BehrensG/ETH1CVOLT/README.md

# ETH1CVOLT
One channel +/- 100V, +/-10V range voltage source
