BehrensG/ETH1CVOLT/HARDWARE/SIM/LTSPICE/ADR1399_Voltage_Reference.asc

C1: cap; 10µ; V=35 Irms=0 Rser=0 Lser=0 mfg="Murata" pn="GRM21BR6YA106ME43" type="X5R"
R1: res; 2k67
R2: res; 100
R3: res; 8k2
R4: res; 8k2
R5: res; 20k
R6: res; 20k
R7: res; 10k
R8: res; 10k
U1: ADR1399H
U2: OPAx192
U3: OPAx192
U4: OPAx192
V1: voltage; 14
V2: voltage; -14
Named nets: 0, VCC, VEE, REF5V, REF10V
.tran 1
