BehrensG/ETH1CVOLT/HARDWARE/SIM/LTSPICE/Draft3.asc

C1: cap; 10µ; V=35 Irms=0 Rser=0 Lser=0 mfg="Murata" pn="GRM21BR6YA106ME43" type="X5R"
R1: res; 2k67
R2: res; 100
U1: ADR1399H
V1: voltage; 14
V2: voltage; -14
Named nets: 0, VCC, VEE
