BehrensG/ETH1CVOLT/HARDWARE/SIM/LTSPICE/Voltage_Source.asc

R1: res; 10k
R2: res; 10k
R3: res; 10k
R4: res; 30k
R5: res; 10k
R6: res; 10k
U1: OPAx192
U2: OPAx192
U3: ADA4522-2
U4: ADA4522-2
U6: MAX44241
V1: voltage; -14
V2: voltage; 14
V3: voltage; -22
V4: voltage; 22
V5: voltage; SINE(0 5 50)
Named nets: 0, VDD, VSS, VGG, VEE, MEAS_R20V, MEAS_R10V, R20V, R10V
.tran 0.1
