BehrensG/ETH1CVOLT/HARDWARE/SIM/LTSPICE/Isolated_Current_Measurement.asc

C1: cap; 0.001µ; V=2K Irms=0 Rser=0.3435 Lser=392p mfg="Würth Elektronik" pn="885342209009 WCAP-CSMH 1210" type="X7R"
R1: res; 10
R2: res; 10k
R3: res; 10k
R4: res; 1Meg
R5: res; 499
R6: res; 1Meg
R7: res; 1Meg
U1: AD8224
V1: voltage; 50
V2: voltage; -15
V3: voltage; 15
Named nets: 0
.tran 0.2
