BehrensG/ETH1CVOLT/HARDWARE/SIM/LTSPICE/Diff_To_Single.asc

R1: res; 49.9k
R2: res; 49.9k
R3: res; 10k
U1: ADA4522
U2: AD8475
V1: voltage; 21
V2: voltage; -21
V3: voltage; SINE(0 25 100 0 0 0 100)
V4: voltage; 5
V5: voltage; 2.5
Named nets: 0, VSS, VCC, VDD, VREF
.tran 0.05
