BehrensG/ETH1CVOLT/HARDWARE/SIM/LTSPICE/Draft1.asc

U1: AD8475
V1: voltage; 5
V2: voltage; SINE(0 10 100 0 0 0 10)
V3: voltage; 5
Named nets: 0, VDD, VREF
