BehrensG/ETH1CVOLT/HARDWARE/SIM/LTSPICE/ADHV4702-1.asc

C1: cap; 82p
Q1: npn; 2N5550
Q2: pnp; 2N5401
R1: res; 40k
R2: res; 10k
R3: res; 120
R4: res; 1k
R5: res; 500
R6: res; 5
R7: res; 500
R8: res; 10k
R9: res; 5
R10: res; 100k
U1: ADHV4702-1
U2: ADHV4702-1
V1: voltage; 110
V2: voltage; -110
V3: voltage; SINE(0 20 1000); AC 10
Named nets: 0, +VCC2, -VCC2
.tran 30m
