BehrensG/ETH1CVOLT/HARDWARE/SIM/LTSPICE/SumAmp.asc

R1: res; 10k
R2: res; 10k
R3: res; 100k
R4: res; 10k
R5: res; 10k
U1: LT1022
U2: LT1022
U3: LT1022
U4: LT1022
V1: voltage; 15
V2: voltage; -15
V3: voltage; -10
V5: voltage; 10
Named nets: 0, P15V, N15V
.tran 0.1
