BehrensG/ETH1CVOLT/HARDWARE/SIM/LTSPICE/Discharge.asc

C1: cap; 4.7µ
C2: cap; 10µ
R1: res; 4k7
S1: sw; MYSW
S2: sw; MYSW
V1: voltage; 110V
V2: voltage; PULSE(5 0 0.5 10n 10n 2 2)
V3: voltage; PULSE(0 5 0.5 10n 10n 2 2)
Named nets: 0
.model MYSW SW()
.tran 2
