BehrensG/ETH1CVOLT/HARDWARE/SIM/LTSPICE/CapacMulti.asc

C1: cap; 100µ
Q1: npn; FZT849
R1: res; 499
R2: res; 499k
R3: res; 10
V1: voltage; 9
Named nets: 0
.tran 0.1
