BehrensG/ETH1CVOLT/HARDWARE/SIM/LTSPICE/LT8330_LV.asc

C1: cap; 1µ
C2: cap; 1µ; V=50 Irms=0 Rser=0 Lser=0 mfg="Murata" pn="GCM21BR71H105MA03" type="X7R"
C3: cap; 4.7p; V=50 Irms=0 Rser=0.4971 Lser=498p mfg="Würth Elektronik" pn="885012007049 WCAP-CSGP 0805" type="NP0"
C4: cap; 4.7µ; V=50 Irms=0 Rser=0 Lser=0 mfg="Murata" pn="GRM31CR71H475KA12" type="X7R"
C5: cap; 10µ; V=50 Irms=0 Rser=0.003 Lser=1.2n mfg="Würth Elektronik" pn="885012214005 WCAP-CSGP 2220" type="X7R"
C11: cap; 1µ
C12: cap; 1µ; V=50 Irms=0 Rser=0 Lser=0 mfg="Murata" pn="GCM21BR71H105MA03" type="X7R"
C13: cap; 4.7p; V=50 Irms=0 Rser=0.4971 Lser=498p mfg="Würth Elektronik" pn="885012007049 WCAP-CSGP 0805" type="NP0"
C14: cap; 4.7µ; V=50 Irms=0 Rser=0 Lser=0 mfg="Murata" pn="GRM31CR71H475KA12" type="X7R"
C15: cap; 10µ; V=50 Irms=0 Rser=0.003 Lser=1.2n mfg="Würth Elektronik" pn="885012214005 WCAP-CSGP 2220" type="X7R"
D1: diode; PMEG6010AED
D3: diode; PMEG6010AED
L1: WE-TDC_HV
L2: WE-TDC_HV
R1: res; 499k
R2: res; 39k
R3: res; 400
R7: res; 499k
R8: res; 18k7
R9: res; 400
U1: LT8330
U3: LT8330
V1: voltage; 24
V3: voltage; 24
Named nets: 0
.tran 0.01
