BehrensG/ETH1CVOLT/HARDWARE/SIM/LTSPICE/LT8330_MV.asc

C11: cap; 1µ
C12: cap; 1µ; V=50 Irms=0 Rser=0 Lser=0 mfg="Murata" pn="GCM21BR71H105MA03" type="X7R"
C13: cap; 4.7p; V=50 Irms=0 Rser=0.4971 Lser=498p mfg="Würth Elektronik" pn="885012007049 WCAP-CSGP 0805" type="NP0"
C14: cap; 4.7µ; V=50 Irms=0 Rser=0 Lser=0 mfg="Murata" pn="GRM31CR71H475KA12" type="X7R"
C15: cap; 10µ; V=50 Irms=0 Rser=0.003 Lser=1.2n mfg="Würth Elektronik" pn="885012214005 WCAP-CSGP 2220" type="X7R"
C16: cap; 1µ
C18: cap; 4.7p; V=50 Irms=0 Rser=0.4971 Lser=498p mfg="Würth Elektronik" pn="885012007049 WCAP-CSGP 0805" type="NP0"
C19: cap; 4.7µ; V=50 Irms=0 Rser=0 Lser=0 mfg="Murata" pn="GRM31CR71H475KA12" type="X7R"
C20: cap; 10µ; V=50 Irms=0 Rser=0.003 Lser=1.2n mfg="Würth Elektronik" pn="885012214005 WCAP-CSGP 2220" type="X7R"
D3: diode; PMEG6010AED
D4: diode; PMEG6010AED
L1: ind; 6.8µ; Ipk=1 Rser=0.25 Rpar=4000 Cpar=1.9p mfg="Würth Elektronik" pn="74479887268A WE-PMI 1008"
L2: WE-TDC_HV
R7: res; 499k
R8: res; 10k
R9: res; 400
R10: res; 499k
R11: res; 18k8
R12: res; 600
U3: LT8330
U4: LT8330
V3: voltage; 24
V4: voltage; 24
Named nets: 0
.tran 0.01
