BehrensG/ETH1CVOLT/HARDWARE/SIM/LTSPICE/LT8365_N.asc

C1: cap; 0.01µ; V=100 Irms=0 Rser=0.0821 Lser=506p mfg="Würth Elektronik" pn="885012208112 WCAP-CSGP 1206" type="X7R"
C2: cap; 0.1µ; V=100 Irms=0 Rser=0 Lser=0 mfg="Murata" pn="GCM21BR72A104KA37" type="X7R"
C3: cap; 0.1µ; V=100 Irms=0 Rser=0 Lser=0 mfg="Murata" pn="GCM21BR72A104KA37" type="X7R"
C4: cap; 1µ
C5: cap; 0.0018µ; V=100 Irms=0 Rser=0 Lser=0 mfg="Murata" pn="GCM155R72A182JA37" type="X7R"
C6: cap; 0.22µ; V=100 Irms=1.43 Rser=0.066313 Lser=0 mfg="KEMET" pn="C1812F224K1RAC" type="X7R"
C7: cap; 0.22µ; V=100 Irms=1.43 Rser=0.066313 Lser=0 mfg="KEMET" pn="C1812F224K1RAC" type="X7R"
C8: cap; 10µ; V=200 Irms=310m Rser=0.7365 Lser=4.499n mfg="Würth Elektronik" pn="860241075003 WCAP-AT1H 10x20" type="Al electrolytic"
C9: cap; 4.7µ; V=250 Irms=60m Rser=1.1257 Lser=4.219n mfg="Würth Elektronik" pn="860131175004 WCAP-ATET 10x12,5" type="Al electrolytic"
C10: cap; 10µ; V=50 Irms=0 Rser=0.008 Lser=402p mfg="Würth Elektronik" pn="885012209073 WCAP-CSGP 1210" type="X7R"
C11: cap; 4.7µ; V=50 Irms=0 Rser=0 Lser=0 mfg="Murata" pn="GRM21BZ71H475KE15" type="X7R"
D1: diode; MBRS1100
D2: diode; MBRS1100
D3: diode; MBRS1100
D4: diode; MBRS1100
L1: ind2; 10µ; Ipk=0.94 Rser=0.19 Rpar=6292.1 Cpar=715f mfg="Würth Elektronik" pn="74406032100 WE-LQFS 3818"
R1: res; 107K
R2: res; 44.2k
R3: res; 20
R4: res; 20
R5: res; 47
R6: res; 499k
R7: res; 499k
R8: res; 7k32
R9: res; 7k4
U1: LT8365
V1: VOLTAGE; 24
Named nets: 0, IN
.tran 0.1 startup
