BehrensG/ETH1CVOLT/HARDWARE/ETH1CVOLT/ETH1CVOLT.kicad_pcb

## KiCad design HARDWARE/ETH1CVOLT/ETH1CVOLT.kicad_pcb (2026-10-23)

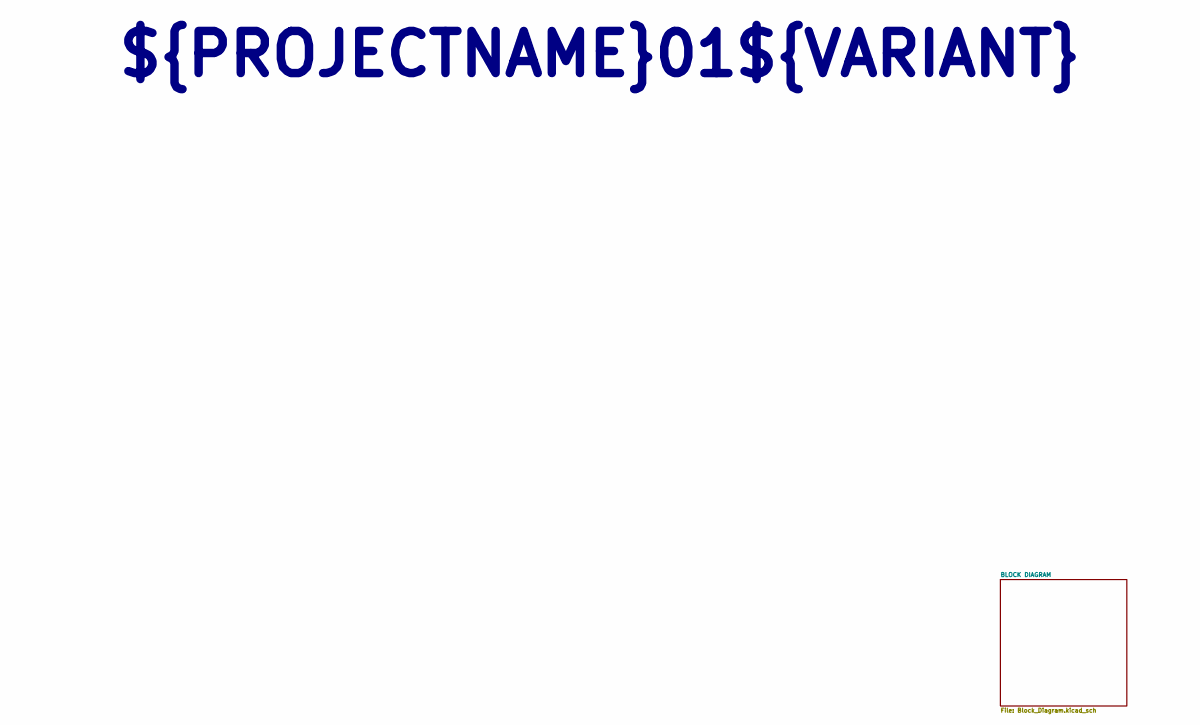
[picture p1: schematic ETH1CVOLT.kicad_sch]

Notes on the sheet:
${PROJECTNAME}${REVISION}${VARIANT}

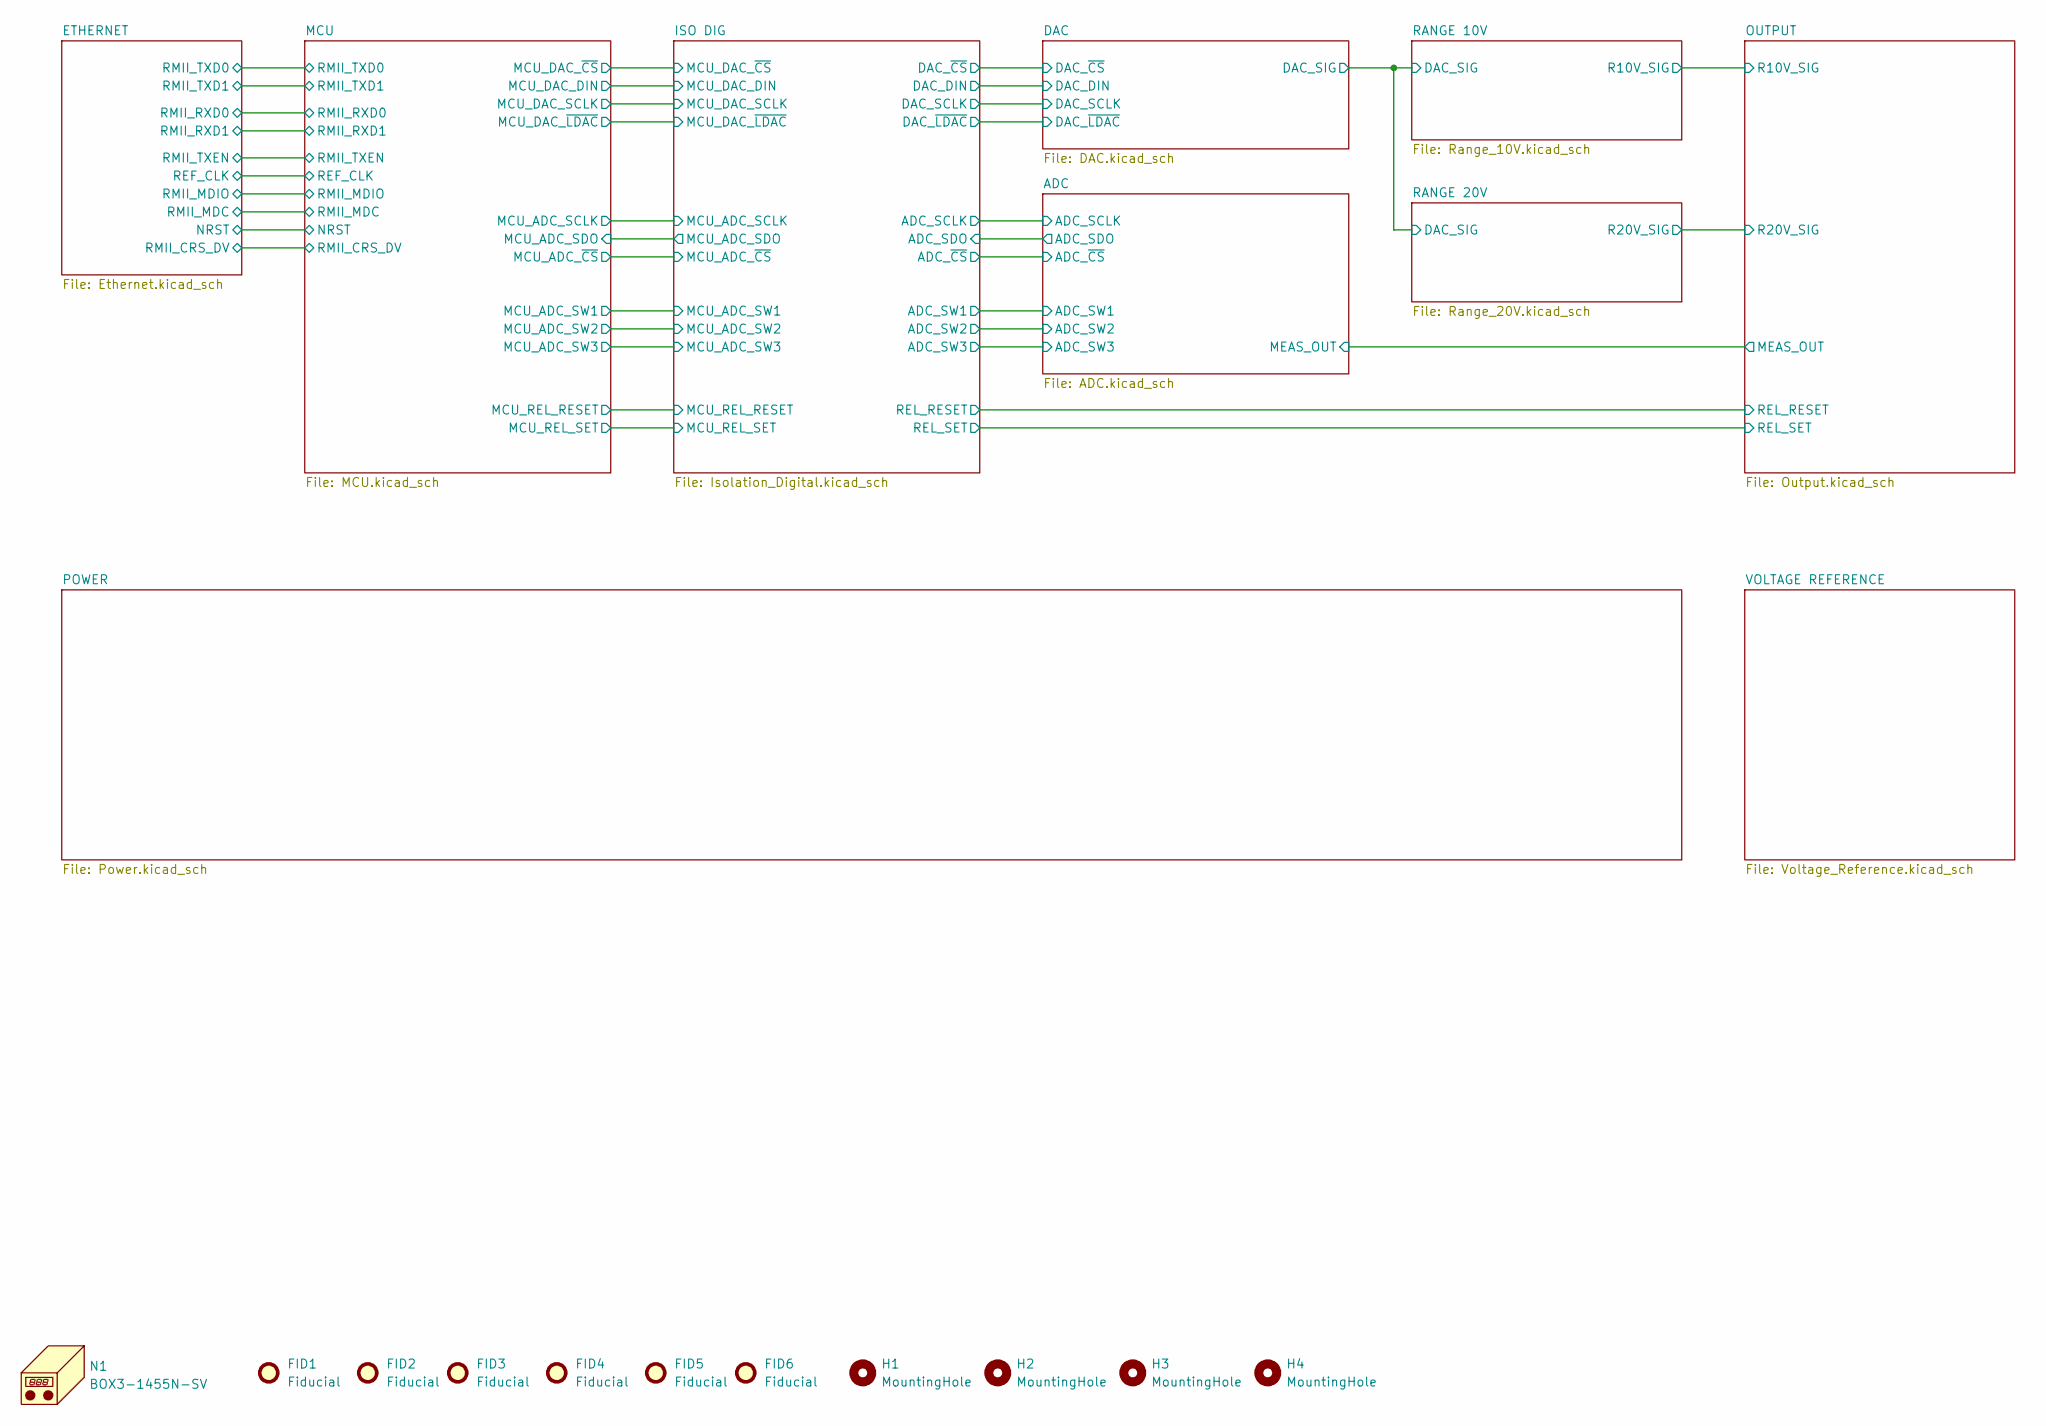
[picture p2: schematic Block_Diagram.kicad_sch, ETH1CVOLT]

Parts:
FID1, FID2, FID3, FID4, FID5, FID6: Fiducial; Fiducial_1.5mm_Mask3mm
H1, H2, H3, H4: MountingHole; MountingHole_3.2mm_M3
N1: BOX3-1455N-SV; BOX3-1455N

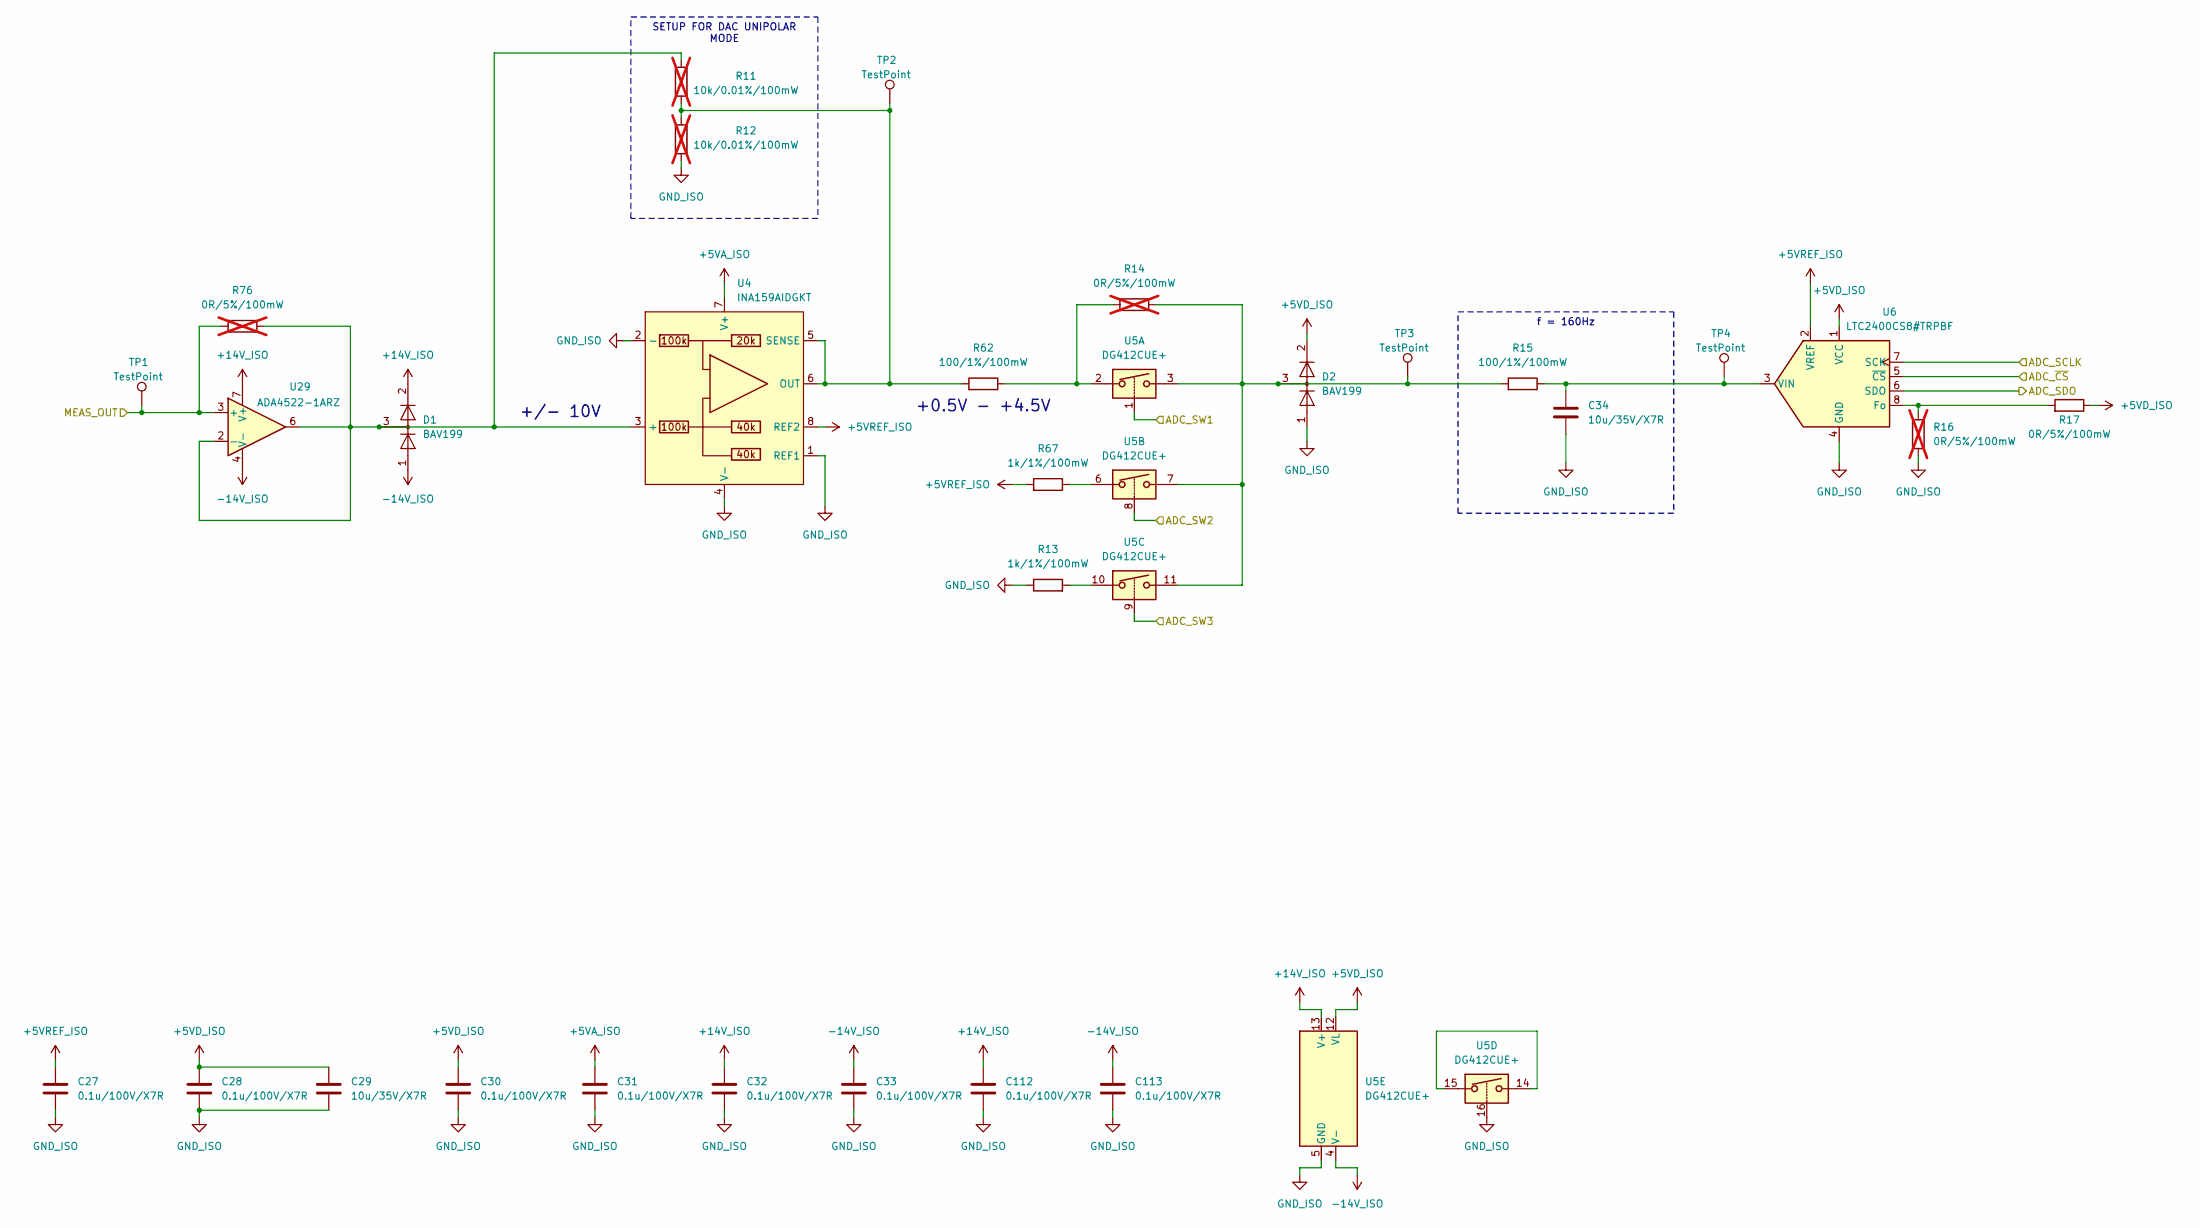
[picture p3: schematic ADC.kicad_sch, ETH1CVOLT]

Parts:
C27, C28, C30, C31, C32, C33, C112, C113: 0.1u/100V/X7R; C_0603_1608Metric_Pad1.08x0.95mm_HandSolder
C29, C34: 10u/35V/X7R; C_1206_3216Metric_Pad1.33x1.80mm_HandSolder
D1, D2: BAV199; SOT-23
R11, R12: 10k/0.01%/100mW; R_0603_1608Metric_Pad0.98x0.95mm_HandSolder; not fitted
R13, R67: 1k/1%/100mW; R_0603_1608Metric_Pad0.98x0.95mm_HandSolder
R14, R16, R76: 0R/5%/100mW; R_0603_1608Metric_Pad0.98x0.95mm_HandSolder; not fitted
R15, R62: 100/1%/100mW; R_0603_1608Metric_Pad0.98x0.95mm_HandSolder
R17: 0R/5%/100mW; R_0603_1608Metric_Pad0.98x0.95mm_HandSolder
TP1, TP2, TP3, TP4: TestPoint; TestPoint_Pad_D1.5mm
U4: INA159AIDGKT; VSSOP-8_3x3mm_P0.65mm
U5: DG412CUE+; TSSOP-16_4.4x5mm_P0.65mm
U6: LTC2400CS8#TRPBF; SOIC-8_3.9x4.9mm_P1.27mm
U29: ADA4522-1ARZ; SOIC-8_3.9x4.9mm_P1.27mm

Connections:
+5VA_ISO: C31.1, U4.7 (V+); also elsewhere on the board
+5VD_ISO: C28.1, C29.1, C30.1, D2.2 (A), R17.1, U5.12 (VL), U6.1 (VCC); also elsewhere on the board
+5VREF_ISO: C27.1, R67.2, U4.8 (REF2), U6.2 (VREF); also elsewhere on the board
+14V_ISO: C32.1, C112.1, D1.2 (A), U5.13 (V+), U29.7 (V+); also elsewhere on the board
-14V_ISO: C33.1, C113.1, D1.1 (K), U5.4 (V-), U29.4 (V-); also elsewhere on the board
/BLOCK DIAGRAM/ADC/ADC_SCLK: U6.7 (SCK); also elsewhere on the board
/BLOCK DIAGRAM/ADC/ADC_SDO: U6.6 (SDO); also elsewhere on the board
/BLOCK DIAGRAM/ADC/ADC_SW1: U5.1; also elsewhere on the board
/BLOCK DIAGRAM/ADC/ADC_SW2: U5.8; also elsewhere on the board
/BLOCK DIAGRAM/ADC/ADC_SW3: U5.9; also elsewhere on the board
/BLOCK DIAGRAM/ADC/ADC_~CS: U6.5 (~CS); also elsewhere on the board
/BLOCK DIAGRAM/ADC/MEAS_OUT: R76.1, TP1.1 (1_1), U29.3 (+); also elsewhere on the board
GND_ISO: C27.2, C28.2, C29.2, C30.2, C31.2, C32.2, C33.2, C34.2, C112.2, C113.2, D2.1 (K), R12.1, R13.1, R16.2, U4.1 (REF1), U4.2 (-), U4.4 (V-), U5.5 (GND), U5.16, U6.4 (GND); also elsewhere on the board
unnamed: D2.3 (K), R14.2, R15.2, TP3.1 (1_1), U5.3, U5.7, U5.11
unnamed: R13.2, U5.10
unnamed: R14.1, R62.1, U5.2
unnamed: R67.1, U5.6
unnamed: R11.1, R12.2, R62.2, TP2.1 (1_1), U4.5 (SENSE), U4.6 (OUT)
unnamed: U5.14, U5.15
unnamed: R16.1, R17.2, U6.8 (Fo)
unnamed: C34.1, R15.1, TP4.1 (1_1), U6.3 (VIN)
unnamed: D1.3 (K), R11.2, R76.2, U4.3 (+), U29.2 (-), U29.6

Notes on the sheet:
+/- 10V
+0.5V - +4.5V
f = 160Hz
SETUP FOR DAC UNIPOLAR MODE

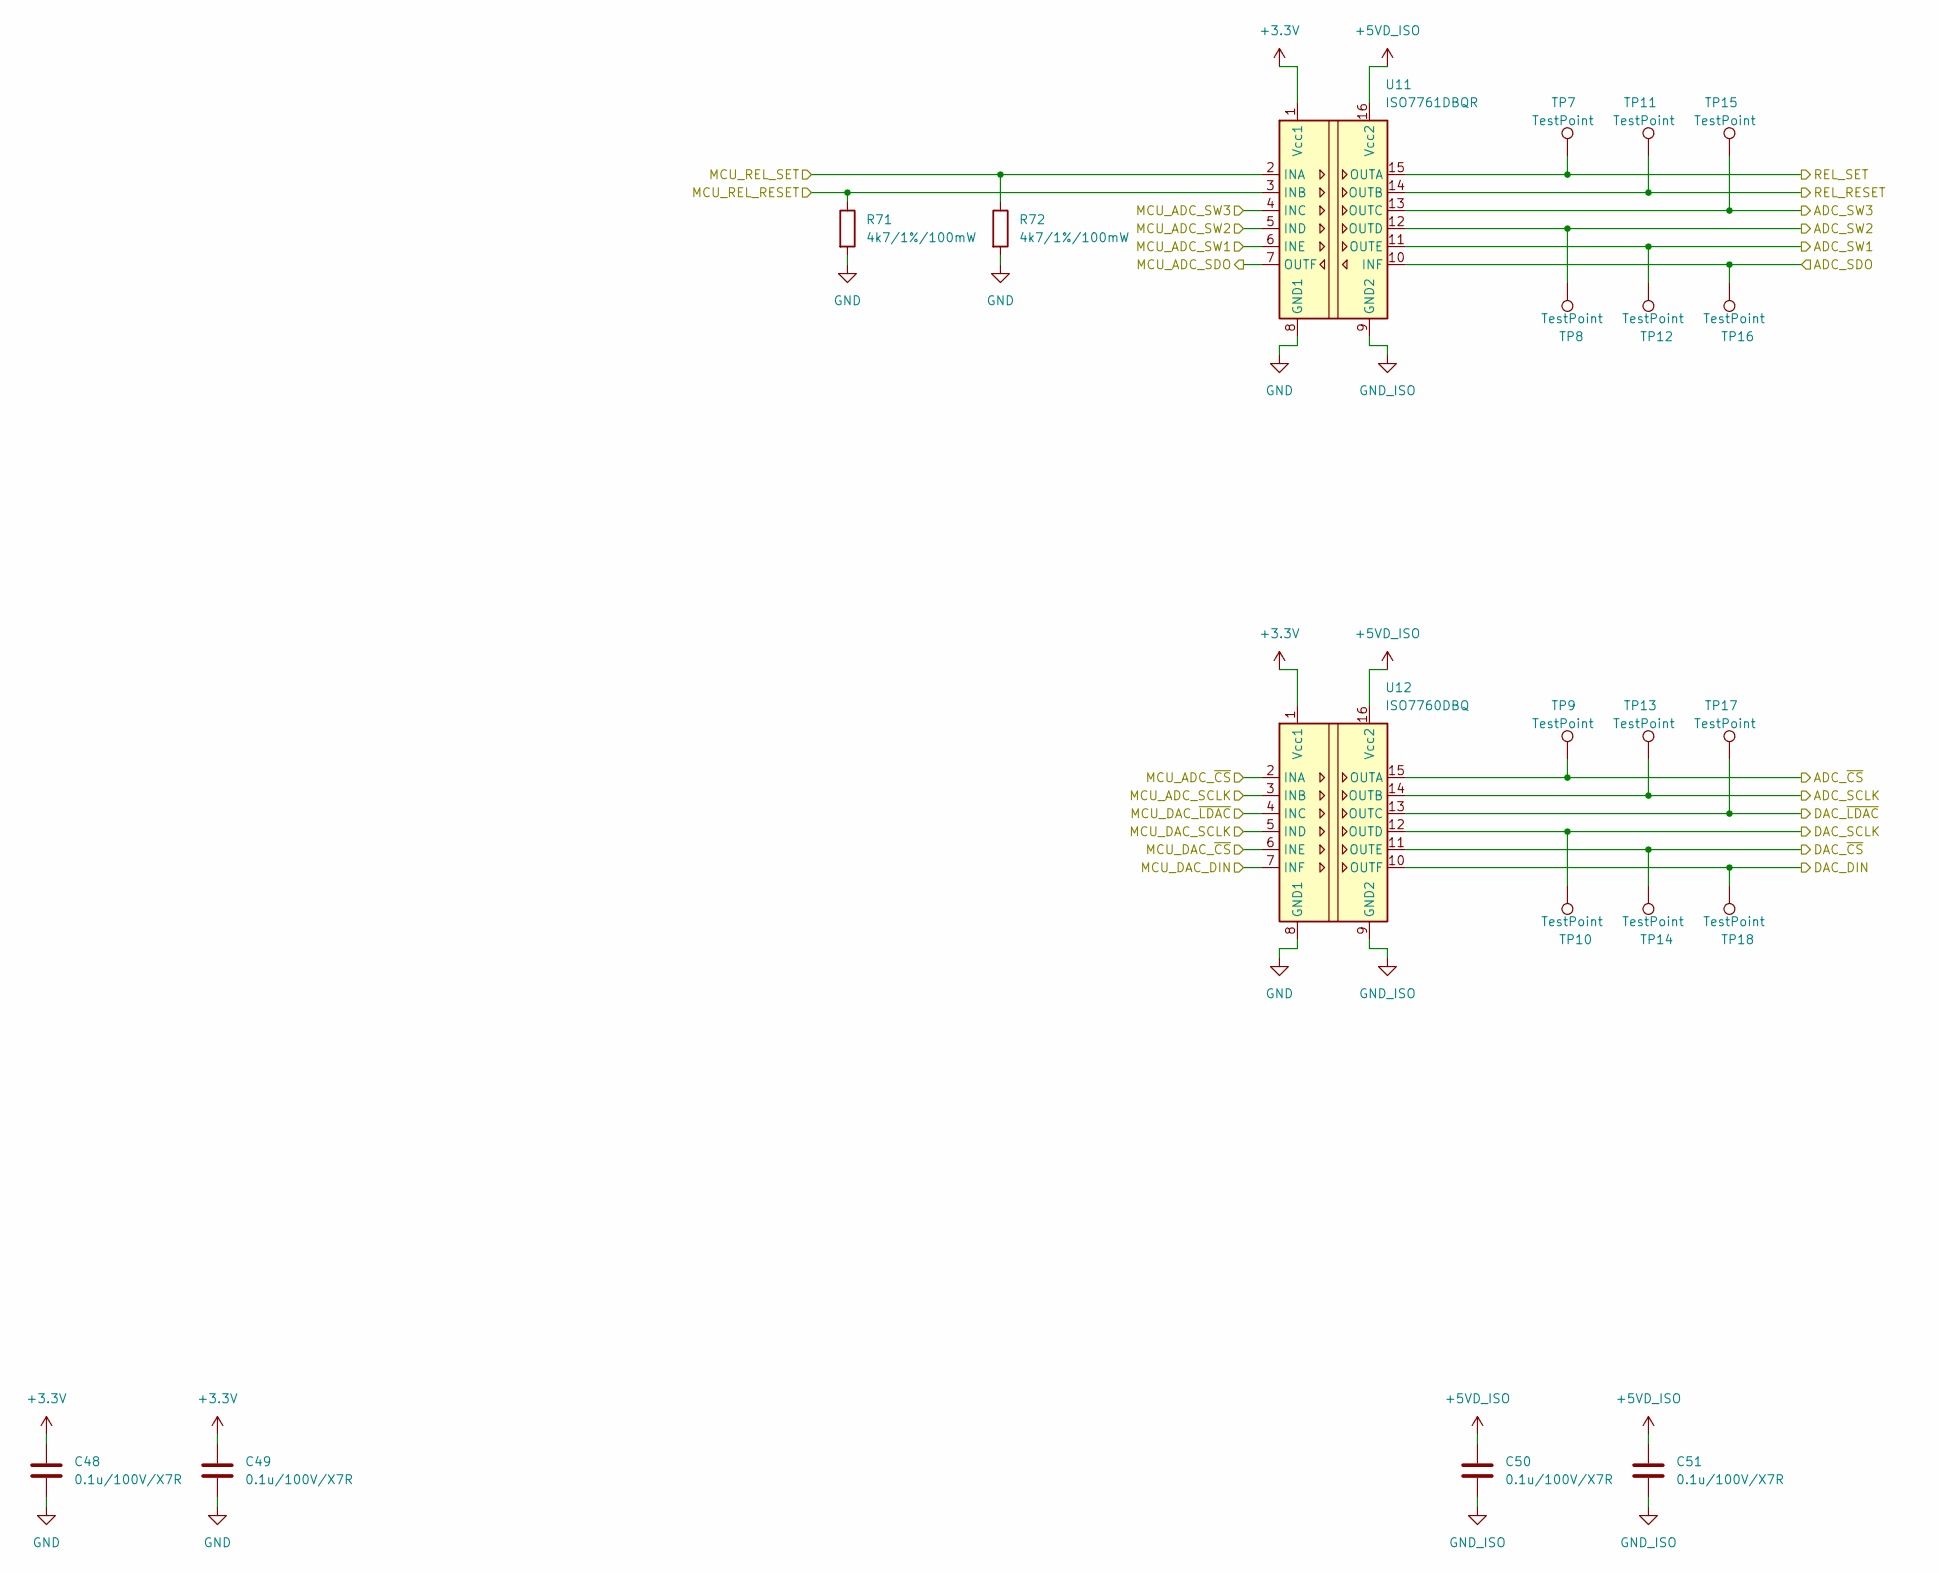
[picture p4: schematic Isolation_Digital.kicad_sch, ETH1CVOLT]

Parts:
C48, C49, C50, C51: 0.1u/100V/X7R; C_0603_1608Metric_Pad1.08x0.95mm_HandSolder
R71, R72: 4k7/1%/100mW; R_0603_1608Metric_Pad0.98x0.95mm_HandSolder
TP7, TP8, TP9, TP10, TP11, TP12, TP13, TP14, TP15, TP16, TP17, TP18: TestPoint; TestPoint_Pad_D1.0mm
U11: ISO7761DBQR; SSOP-16_3.9x4.9mm_P0.635mm
U12: ISO7760DBQ; SSOP-16_3.9x4.9mm_P0.635mm

Connections:
+3.3V: C48.1, C49.1, U11.1 (Vcc1), U12.1 (Vcc1); also elsewhere on the board
+5VD_ISO: C50.1, C51.1, U11.16 (Vcc2), U12.16 (Vcc2); also elsewhere on the board
/BLOCK DIAGRAM/ADC/ADC_SCLK: TP13.1 (1_1), U12.14 (OUTB); also elsewhere on the board
/BLOCK DIAGRAM/ADC/ADC_SDO: TP16.1 (1_1), U11.10 (INF); also elsewhere on the board
/BLOCK DIAGRAM/ADC/ADC_SW1: TP12.1 (1_1), U11.11 (OUTE); also elsewhere on the board
/BLOCK DIAGRAM/ADC/ADC_SW2: TP8.1 (1_1), U11.12 (OUTD); also elsewhere on the board
/BLOCK DIAGRAM/ADC/ADC_SW3: TP15.1 (1_1), U11.13 (OUTC); also elsewhere on the board
/BLOCK DIAGRAM/ADC/ADC_~CS: TP9.1 (1_1), U12.15 (OUTA); also elsewhere on the board
/BLOCK DIAGRAM/DAC/DAC_DIN: TP18.1 (1_1), U12.10 (OUTF); also elsewhere on the board
/BLOCK DIAGRAM/DAC/DAC_SCLK: TP10.1 (1_1), U12.12 (OUTD); also elsewhere on the board
/BLOCK DIAGRAM/DAC/DAC_~CS: TP14.1 (1_1), U12.11 (OUTE); also elsewhere on the board
/BLOCK DIAGRAM/DAC/DAC_~LDAC: TP17.1 (1_1), U12.13 (OUTC); also elsewhere on the board
/BLOCK DIAGRAM/ISO DIG/MCU_ADC_SCLK: U12.3 (INB); also elsewhere on the board
/BLOCK DIAGRAM/ISO DIG/MCU_ADC_SDO: U11.7 (OUTF); also elsewhere on the board
/BLOCK DIAGRAM/ISO DIG/MCU_ADC_SW1: U11.6 (INE); also elsewhere on the board
/BLOCK DIAGRAM/ISO DIG/MCU_ADC_SW2: U11.5 (IND); also elsewhere on the board
/BLOCK DIAGRAM/ISO DIG/MCU_ADC_SW3: U11.4 (INC); also elsewhere on the board
/BLOCK DIAGRAM/ISO DIG/MCU_ADC_~CS: U12.2 (INA); also elsewhere on the board
/BLOCK DIAGRAM/ISO DIG/MCU_DAC_DIN: U12.7 (INF); also elsewhere on the board
/BLOCK DIAGRAM/ISO DIG/MCU_DAC_SCLK: U12.5 (IND); also elsewhere on the board
/BLOCK DIAGRAM/ISO DIG/MCU_DAC_~CS: U12.6 (INE); also elsewhere on the board
/BLOCK DIAGRAM/ISO DIG/MCU_DAC_~LDAC: U12.4 (INC); also elsewhere on the board
/BLOCK DIAGRAM/ISO DIG/MCU_REL_RESET: R71.1, U11.3 (INB); also elsewhere on the board
/BLOCK DIAGRAM/ISO DIG/MCU_REL_SET: R72.1, U11.2 (INA); also elsewhere on the board
/BLOCK DIAGRAM/ISO DIG/REL_RESET: TP11.1 (1_1), U11.14 (OUTB); also elsewhere on the board
/BLOCK DIAGRAM/ISO DIG/REL_SET: TP7.1 (1_1), U11.15 (OUTA); also elsewhere on the board
GND: C48.2, C49.2, R71.2, R72.2, U11.8 (GND1), U12.8 (GND1); also elsewhere on the board
GND_ISO: C50.2, C51.2, U11.9 (GND2), U12.9 (GND2); also elsewhere on the board

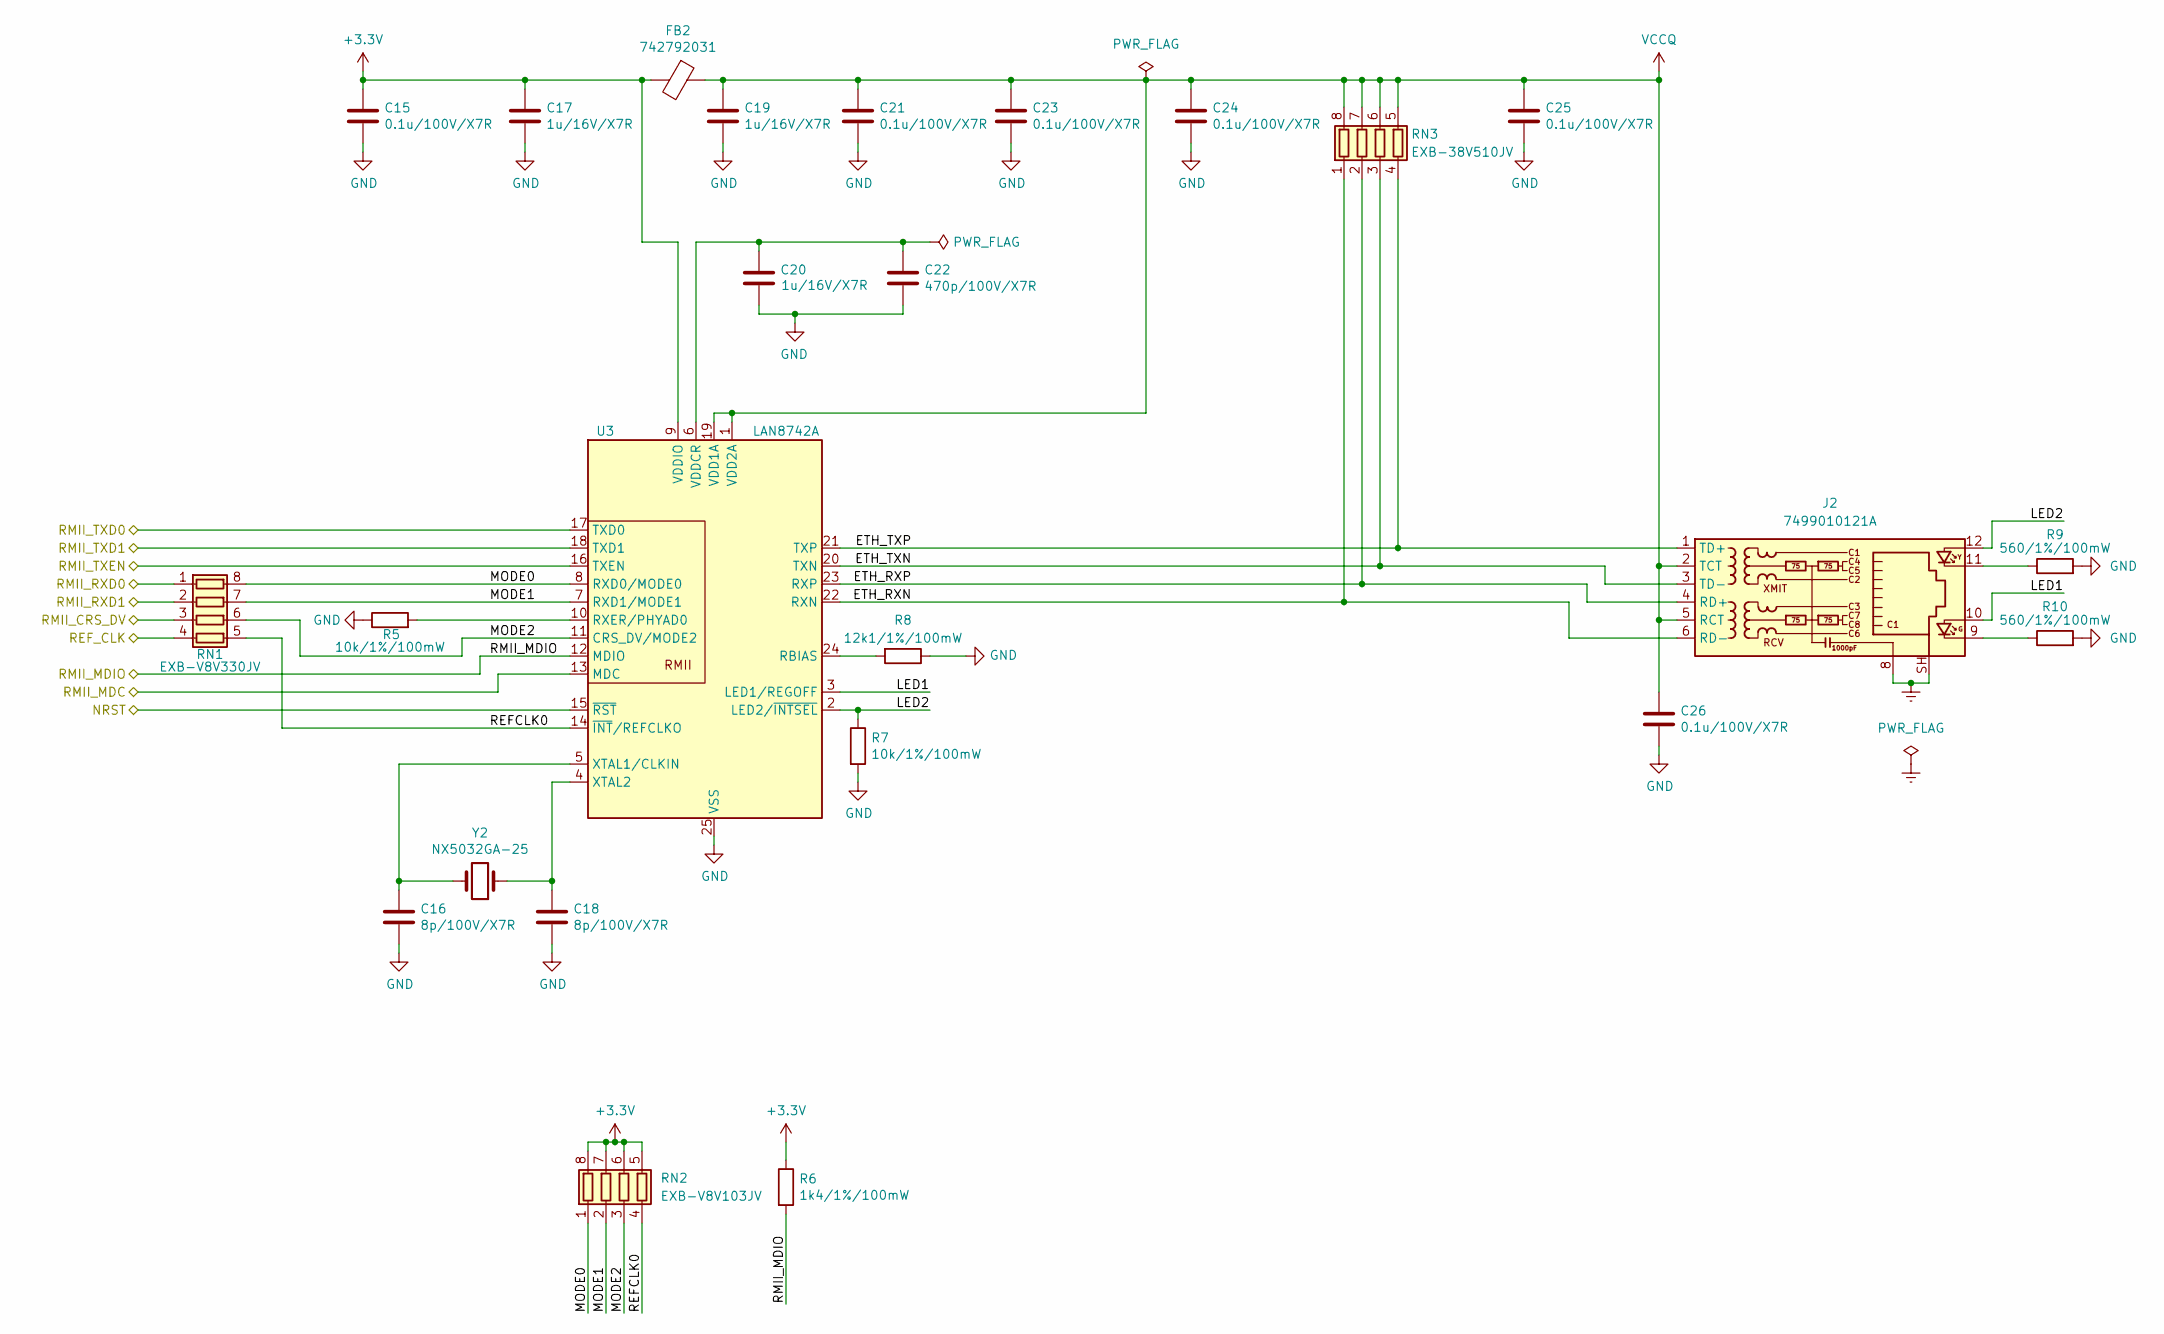
[picture p5: schematic Ethernet.kicad_sch, ETH1CVOLT]

Parts:
C15, C21, C23, C24, C25, C26: 0.1u/100V/X7R; C_0603_1608Metric_Pad1.08x0.95mm_HandSolder
C16, C18: 8p/100V/X7R; C_0603_1608Metric_Pad1.08x0.95mm_HandSolder
C17, C19, C20: 1u/16V/X7R; C_0603_1608Metric_Pad1.08x0.95mm_HandSolder
C22: 470p/100V/X7R; C_0603_1608Metric_Pad1.08x0.95mm_HandSolder
FB2: 742792031; L_0805_2012Metric_Pad1.05x1.20mm_HandSolder
J2: 7499010121A; RJ45_Wuerth_7499010121A_Horizontal
R5, R7: 10k/1%/100mW; R_0603_1608Metric_Pad0.98x0.95mm_HandSolder
R6: 1k4/1%/100mW; R_0603_1608Metric_Pad0.98x0.95mm_HandSolder
R8: 12k1/1%/100mW; R_0603_1608Metric_Pad0.98x0.95mm_HandSolder
R9, R10: 560/1%/100mW; R_0603_1608Metric_Pad0.98x0.95mm_HandSolder
RN1: EXB-V8V330JV; R_Array_Convex_4x0603
RN2: EXB-V8V103JV; R_Array_Convex_4x0603
RN3: EXB-38V510JV; R_Array_Convex_4x0603
U3: LAN8742A; VQFN-24-1EP_4x4mm_P0.5mm_EP2.5x2.5mm_ThermalVias
Y2: NX5032GA-25; NX5032GA

Connections:
+3.3V: C15.1, C17.1, FB2.2, R6.1, RN2.5 (R4.2), RN2.6 (R3.2), RN2.7 (R2.2), RN2.8 (R1.2), U3.9 (VDDIO); also elsewhere on the board
/BLOCK DIAGRAM/ETHERNET/ETH_RXN: J2.6 (RD-), RN3.1 (R1.1), U3.22 (RXN)
/BLOCK DIAGRAM/ETHERNET/ETH_RXP: J2.4 (RD+), RN3.2 (R2.1), U3.23 (RXP)
/BLOCK DIAGRAM/ETHERNET/ETH_TXN: J2.3 (TD-), RN3.3 (R3.1), U3.20 (TXN)
/BLOCK DIAGRAM/ETHERNET/ETH_TXP: J2.1 (TD+), RN3.4 (R4.1), U3.21 (TXP)
/BLOCK DIAGRAM/ETHERNET/LED1: J2.10, U3.3 (LED1/REGOFF)
/BLOCK DIAGRAM/ETHERNET/LED2: J2.12, R7.1, U3.2 (LED2/~INTSEL)
/BLOCK DIAGRAM/ETHERNET/MODE0: RN1.8 (R1.2), RN2.1 (R1.1), U3.8 (RXD0/MODE0)
/BLOCK DIAGRAM/ETHERNET/MODE1: RN1.7 (R2.2), RN2.2 (R2.1), U3.7 (RXD1/MODE1)
/BLOCK DIAGRAM/ETHERNET/MODE2: RN1.6 (R3.2), RN2.3 (R3.1), U3.11 (CRS_DV/MODE2)
/BLOCK DIAGRAM/ETHERNET/REFCLK0: RN1.5 (R4.2), RN2.4 (R4.1), U3.14 (~INT/REFCLKO)
/BLOCK DIAGRAM/ETHERNET/REF_CLK: RN1.4 (R4.1); also elsewhere on the board
/BLOCK DIAGRAM/ETHERNET/RMII_CRS_DV: RN1.3 (R3.1); also elsewhere on the board
/BLOCK DIAGRAM/ETHERNET/RMII_MDC: U3.13 (MDC); also elsewhere on the board
/BLOCK DIAGRAM/ETHERNET/RMII_MDIO: R6.2, U3.12 (MDIO); also elsewhere on the board
/BLOCK DIAGRAM/ETHERNET/RMII_RXD0: RN1.1 (R1.1); also elsewhere on the board
/BLOCK DIAGRAM/ETHERNET/RMII_RXD1: RN1.2 (R2.1); also elsewhere on the board
/BLOCK DIAGRAM/ETHERNET/RMII_TXD0: U3.17 (TXD0); also elsewhere on the board
/BLOCK DIAGRAM/ETHERNET/RMII_TXD1: U3.18 (TXD1); also elsewhere on the board
/BLOCK DIAGRAM/ETHERNET/RMII_TXEN: U3.16 (TXEN); also elsewhere on the board
/BLOCK DIAGRAM/MCU/NRST: U3.15 (~RST); also elsewhere on the board
Earth: J2.8, J2.SH
GND: C15.2, C16.2, C17.2, C18.2, C19.2, C20.2, C21.2, C22.2, C23.2, C24.2, C25.2, C26.2, R5.1, R7.2, R8.1, R9.2, R10.2, U3.25 (VSS); also elsewhere on the board
unnamed: J2.9, R10.1
unnamed: J2.11, R9.1
unnamed: R8.2, U3.24 (RBIAS)
unnamed: R5.2, U3.10 (RXER/PHYAD0)
unnamed: C20.1, C22.1, U3.6 (VDDCR)
unnamed: C16.1, U3.5 (XTAL1/CLKIN), Y2.2
unnamed: C18.1, U3.4 (XTAL2), Y2.1
VCCQ: C19.1, C21.1, C23.1, C24.1, C25.1, C26.1, FB2.1, J2.2 (TCT), J2.5 (RCT), RN3.5 (R4.2), RN3.6 (R3.2), RN3.7 (R2.2), RN3.8 (R1.2), U3.1 (VDD2A), U3.19 (VDD1A)

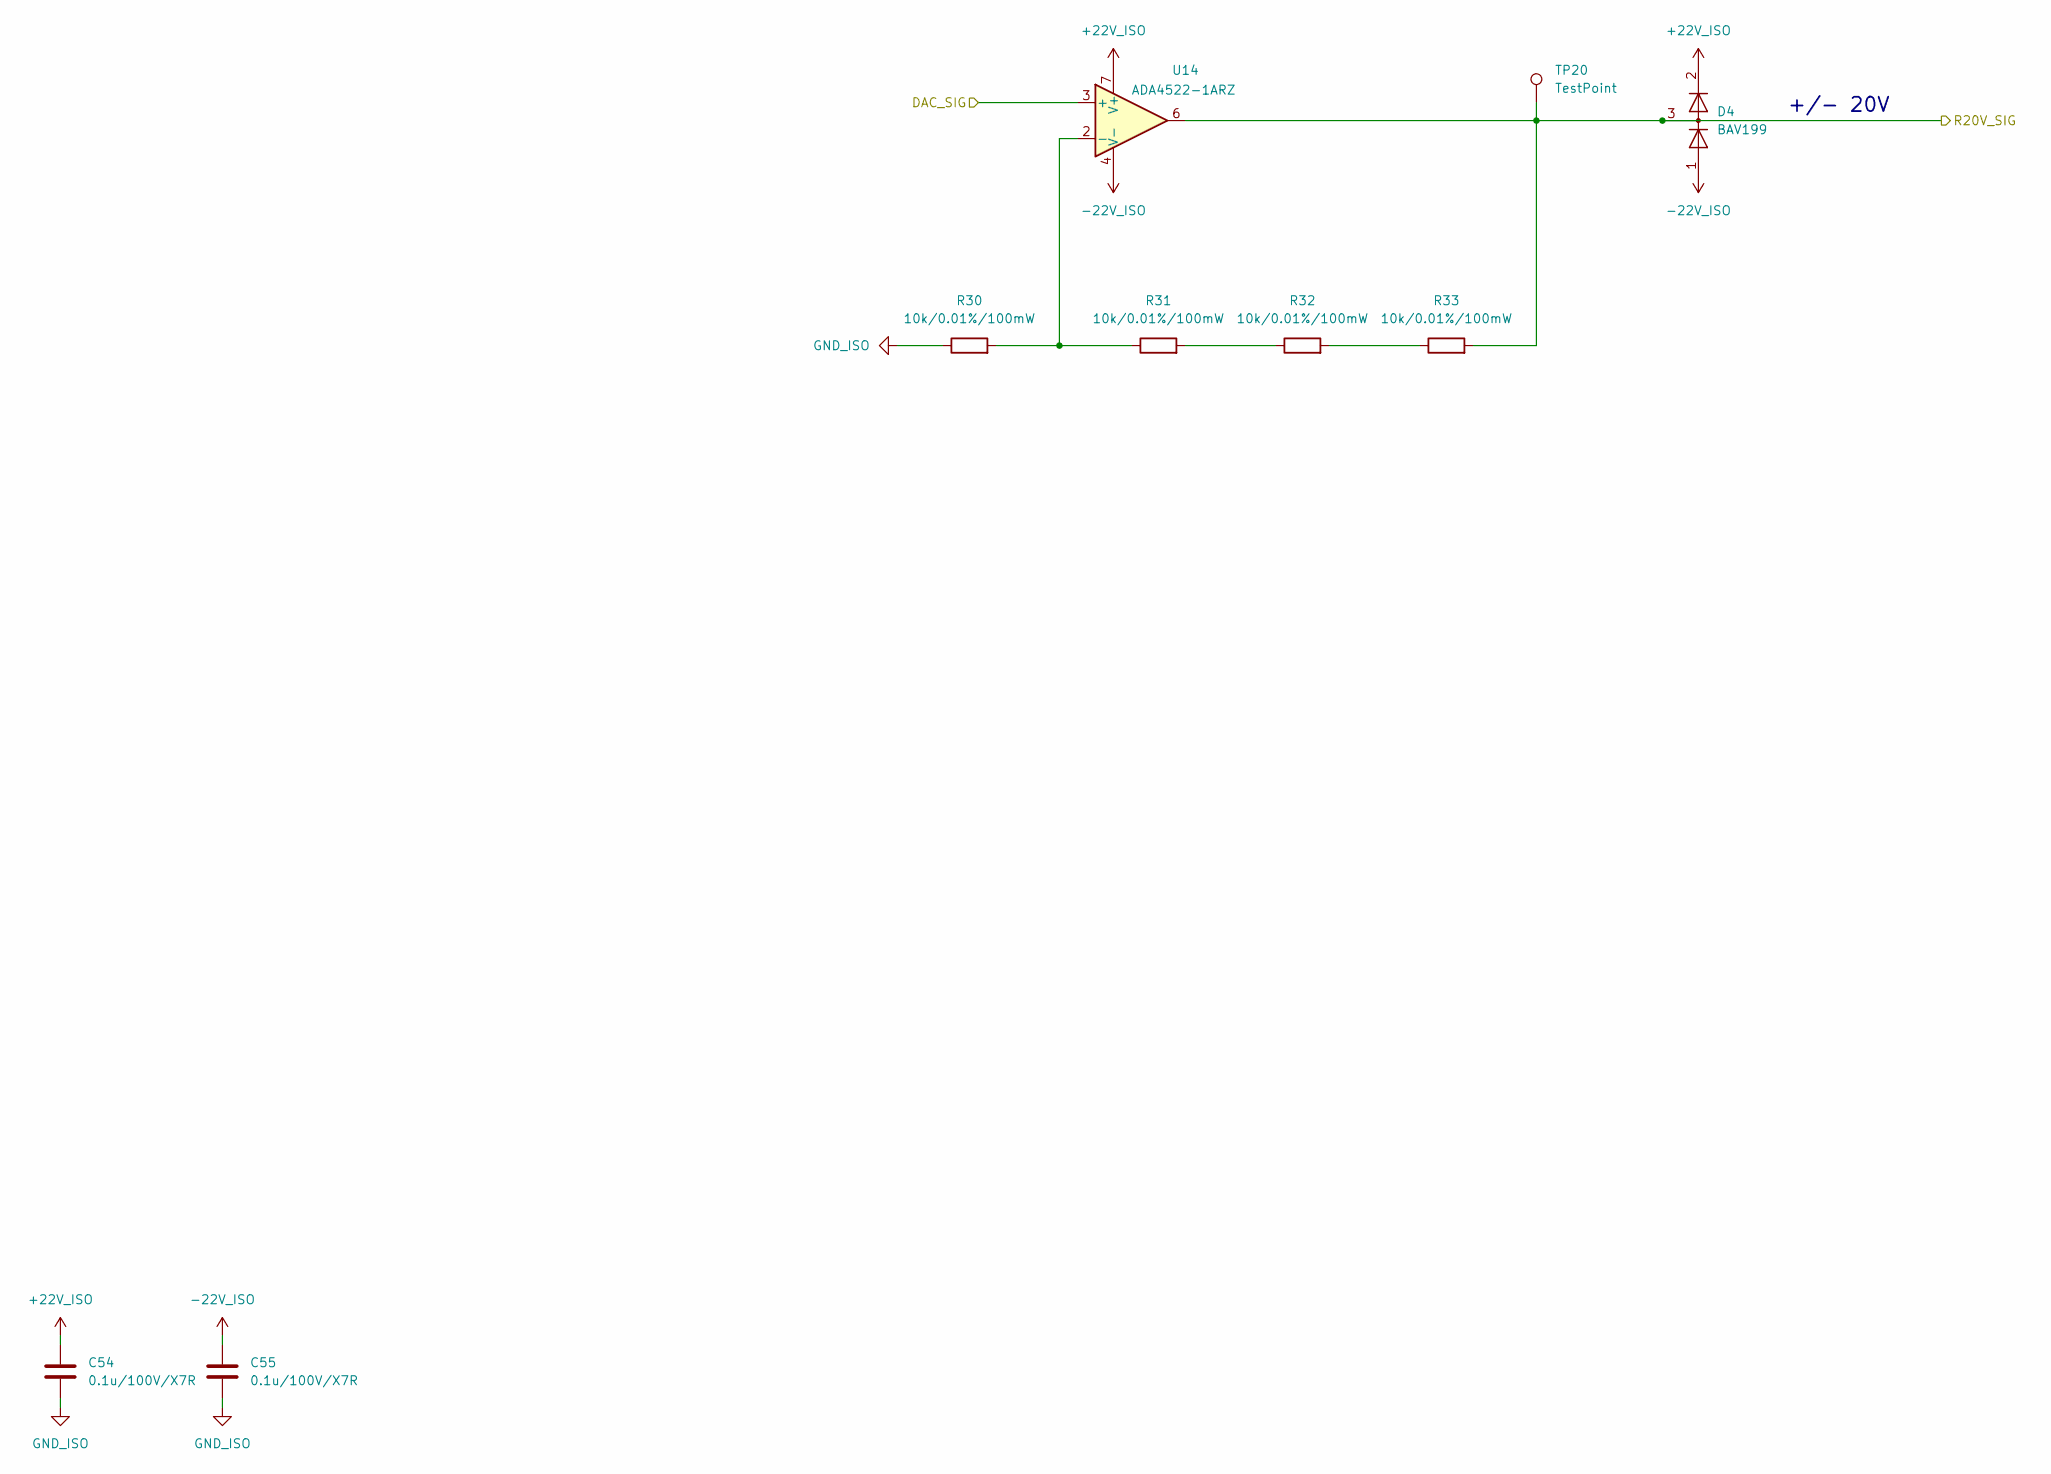
[picture p6: schematic Range_20V.kicad_sch, ETH1CVOLT]

Parts:
C54, C55: 0.1u/100V/X7R; C_0603_1608Metric_Pad1.08x0.95mm_HandSolder
D4: BAV199; SOT-23
R30, R31, R32, R33: 10k/0.01%/100mW; R_0603_1608Metric_Pad0.98x0.95mm_HandSolder
TP20: TestPoint; TestPoint_Pad_D1.5mm
U14: ADA4522-1ARZ; SOIC-8_3.9x4.9mm_P1.27mm

Connections:
+22V_ISO: C54.1, D4.2 (A), U14.7 (V+); also elsewhere on the board
-22V_ISO: C55.1, D4.1 (K), U14.4 (V-); also elsewhere on the board
/BLOCK DIAGRAM/DAC/DAC_SIG: U14.3 (+); also elsewhere on the board
/BLOCK DIAGRAM/OUTPUT/R20V_SIG: D4.3 (K), R33.2, TP20.1 (1_1), U14.6; also elsewhere on the board
GND_ISO: C54.2, C55.2, R30.1; also elsewhere on the board
unnamed: R31.2, R32.1
unnamed: R32.2, R33.1
unnamed: R30.2, R31.1, U14.2 (-)

Notes on the sheet:
+/- 20V
