BehrensG/ETH1CVOLT/HARDWARE/ETH1CVOLT/ETH1CVOLT.kicad_pcb

## KiCad design HARDWARE/ETH1CVOLT/ETH1CVOLT.kicad_pcb (continued)

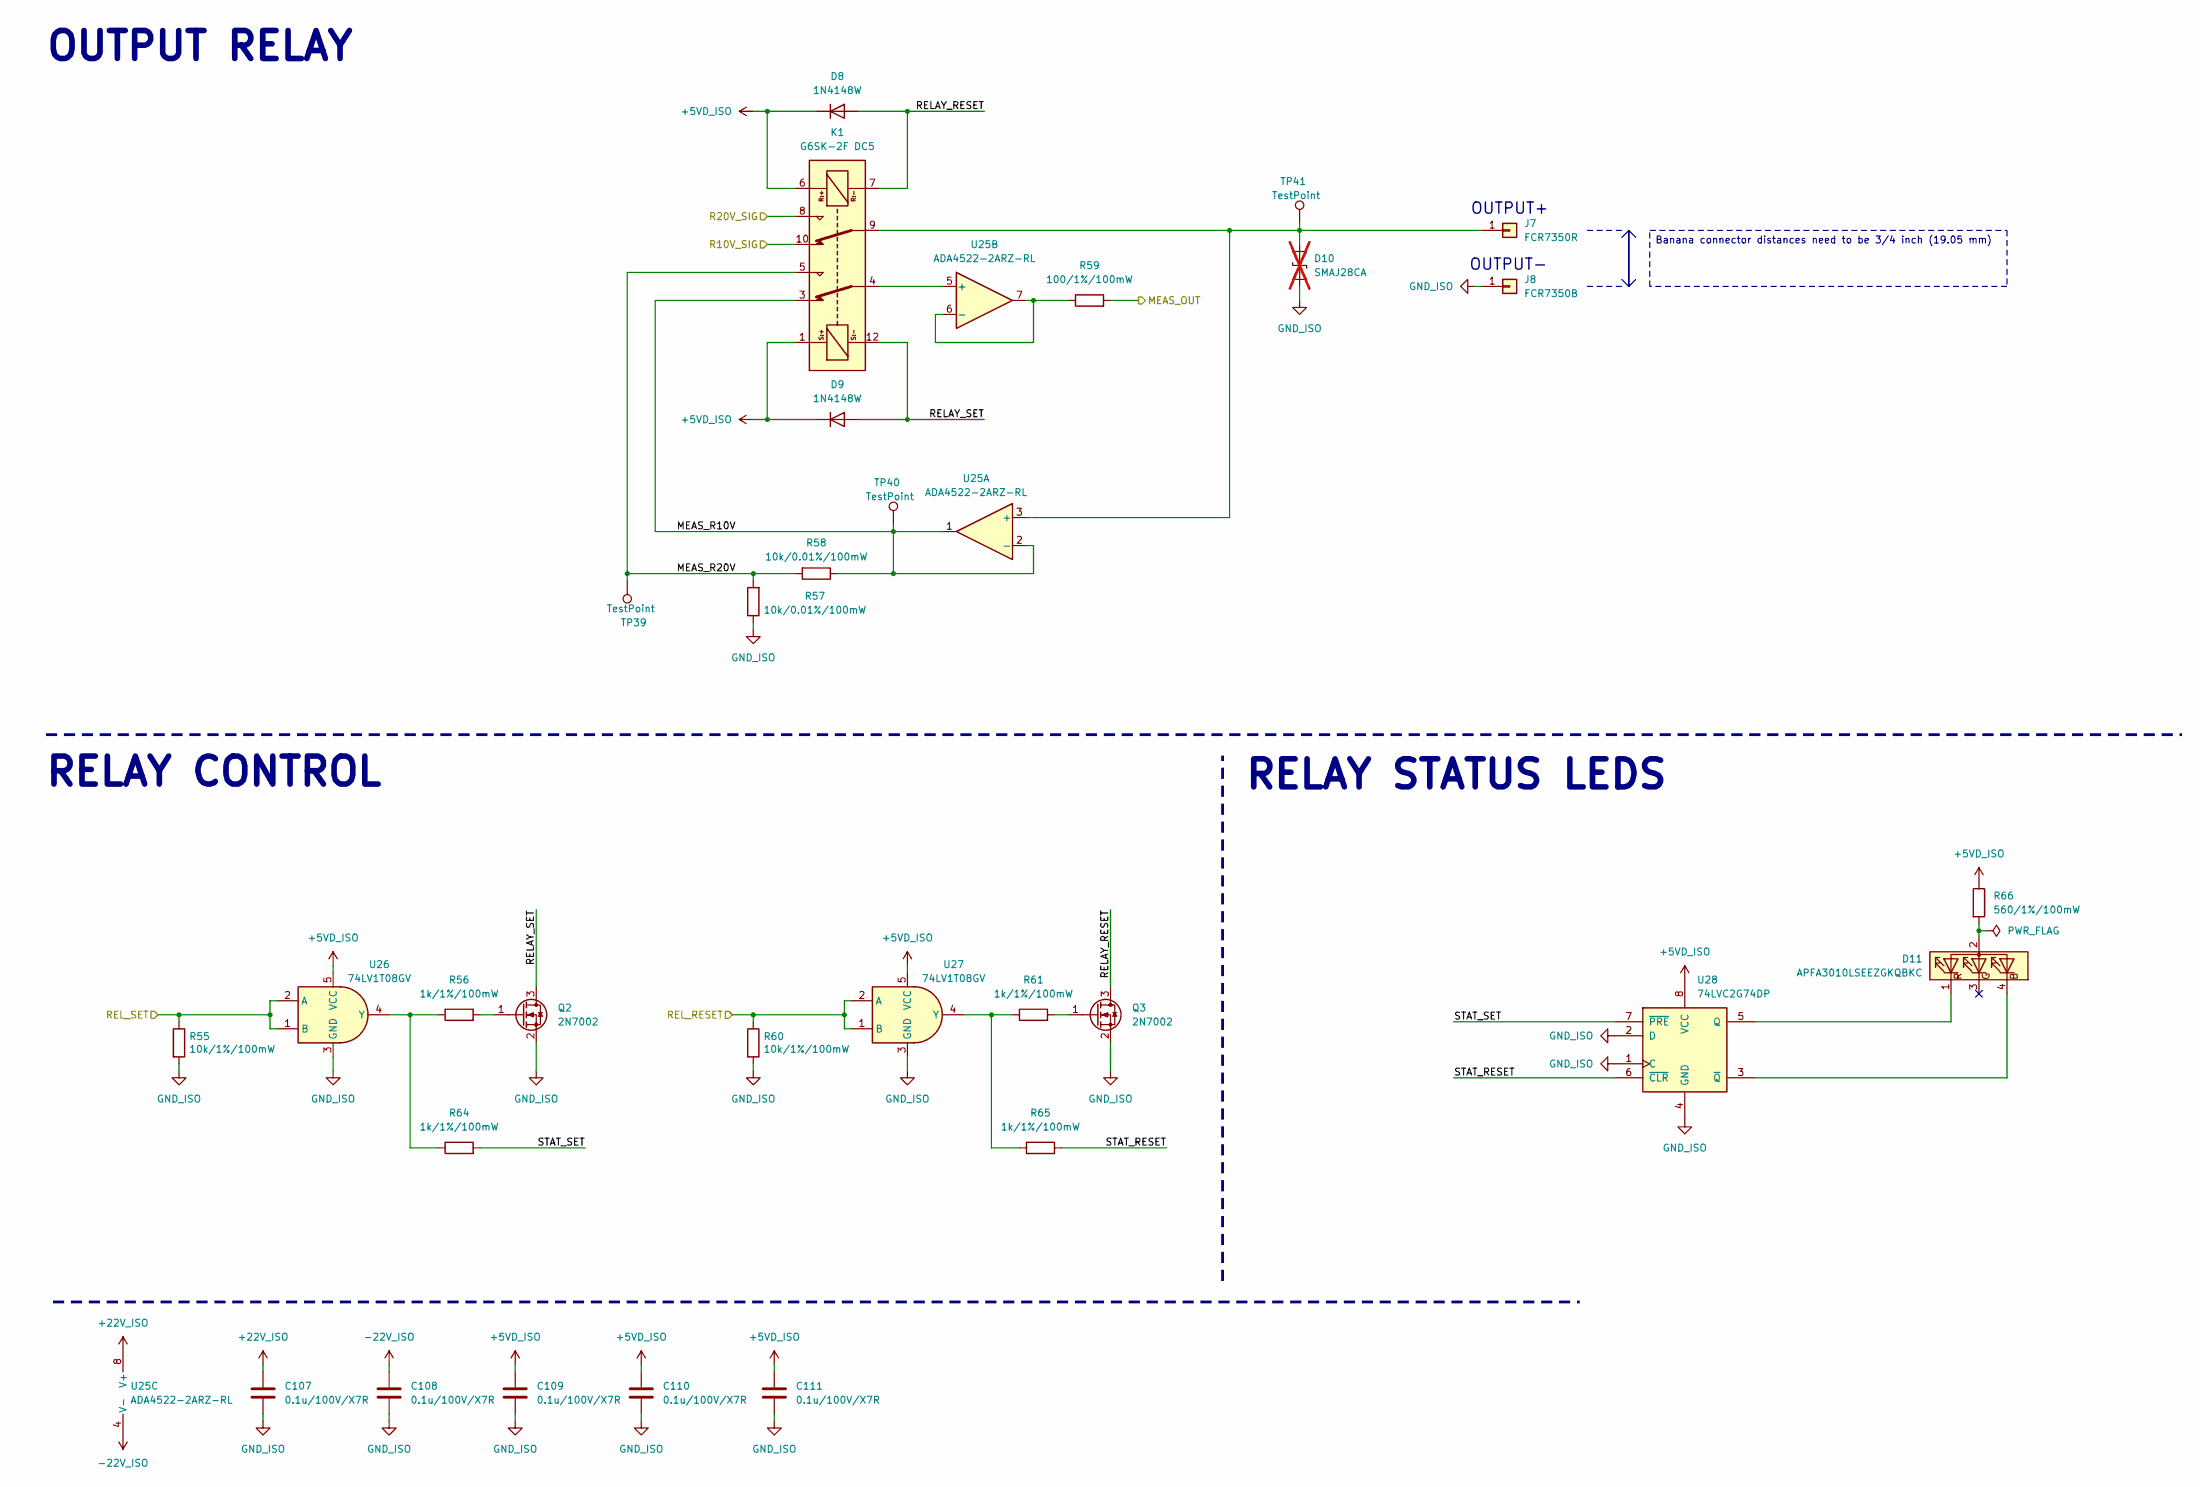
[picture p7: schematic Output.kicad_sch, ETH1CVOLT]

Parts:
C107, C108, C109, C110, C111: 0.1u/100V/X7R; C_0603_1608Metric_Pad1.08x0.95mm_HandSolder
D8, D9: 1N4148W; D_SOD-123
D10: SMAJ28CA; D_SMA; not fitted
D11: APFA3010LSEEZGKQBKC; LED_Kingbright_APFA3010_3x1.5mm_Horizontal
J7: FCR7350R; S16N-PC
J8: FCR7350B; S16N-PC
K1: G6SK-2F DC5; Relay_DPDT_Omron_G6SK-2F
Q2, Q3: 2N7002; SOT-23
R55, R60: 10k/1%/100mW; R_0603_1608Metric_Pad0.98x0.95mm_HandSolder
R56, R61, R64, R65: 1k/1%/100mW; R_0603_1608Metric_Pad0.98x0.95mm_HandSolder
R57, R58: 10k/0.01%/100mW; R_0603_1608Metric_Pad0.98x0.95mm_HandSolder
R59: 100/1%/100mW; R_0603_1608Metric_Pad0.98x0.95mm_HandSolder
R66: 560/1%/100mW; R_0603_1608Metric_Pad0.98x0.95mm_HandSolder
TP39, TP40, TP41: TestPoint; TestPoint_Pad_D1.5mm
U25: ADA4522-2ARZ-RL; SOIC-8_3.9x4.9mm_P1.27mm
U26, U27: 74LV1T08GV; SC-74A-5_1.55x2.9mm_P0.95mm
U28: 74LVC2G74DP; TSSOP-8_3x3mm_P0.65mm

Connections:
+5VD_ISO: C109.1, C110.1, C111.1, D8.1 (K), D9.1 (K), K1.1, K1.6, R66.1, U26.5 (VCC), U27.5 (VCC), U28.8 (VCC); also elsewhere on the board
+22V_ISO: C107.1, U25.8 (V+); also elsewhere on the board
-22V_ISO: C108.1, U25.4 (V-); also elsewhere on the board
/BLOCK DIAGRAM/ADC/MEAS_OUT: R59.2; also elsewhere on the board
/BLOCK DIAGRAM/ISO DIG/REL_RESET: R60.1, U27.1 (B), U27.2 (A); also elsewhere on the board
/BLOCK DIAGRAM/ISO DIG/REL_SET: R55.1, U26.1 (B), U26.2 (A); also elsewhere on the board
/BLOCK DIAGRAM/OUTPUT/MEAS_R10V: K1.3, R58.1, TP40.1 (1_1), U25.1, U25.2 (-)
/BLOCK DIAGRAM/OUTPUT/MEAS_R20V: K1.5, R57.2, R58.2, TP39.1 (1_1)
/BLOCK DIAGRAM/OUTPUT/R10V_SIG: K1.10; also elsewhere on the board
/BLOCK DIAGRAM/OUTPUT/R20V_SIG: K1.8; also elsewhere on the board
/BLOCK DIAGRAM/OUTPUT/RELAY_RESET: D8.2 (A), K1.7, Q3.3 (D)
/BLOCK DIAGRAM/OUTPUT/RELAY_SET: D9.2 (A), K1.12, Q2.3 (D)
/BLOCK DIAGRAM/OUTPUT/STAT_RESET: R65.2, U28.6 (~CLR)
/BLOCK DIAGRAM/OUTPUT/STAT_SET: R64.2, U28.7 (~PRE)
GND_ISO: C107.2, C108.2, C109.2, C110.2, C111.2, D10.1 (A1), J8.1 (Pin_1_1), Q2.2 (S), Q3.2 (S), R55.2, R57.1, R60.2, U26.3 (GND), U27.3 (GND), U28.1 (C), U28.2 (D), U28.4 (GND); also elsewhere on the board
unnamed: D10.2 (A2), J7.1 (Pin_1_1), K1.9, TP41.1 (1_1), U25.3 (+)
unnamed: D11.2 (A), R66.2
unnamed: D11.4 (B), U28.3 (~Q)
unnamed: D11.1 (R), U28.5 (Q)
unnamed: Q2.1 (G), R56.2
unnamed: Q3.1 (G), R61.2
unnamed: K1.4, U25.5 (+)
unnamed: R59.1, U25.6 (-), U25.7
unnamed: R56.1, R64.1, U26.4 (Y)
unnamed: R61.1, R65.1, U27.4 (Y)

Notes on the sheet:
RELAY CONTROL
OUTPUT-
OUTPUT+
OUTPUT RELAY
RELAY STATUS LEDS
Banana connector distances need to be 3/4 inch (19.05 mm)

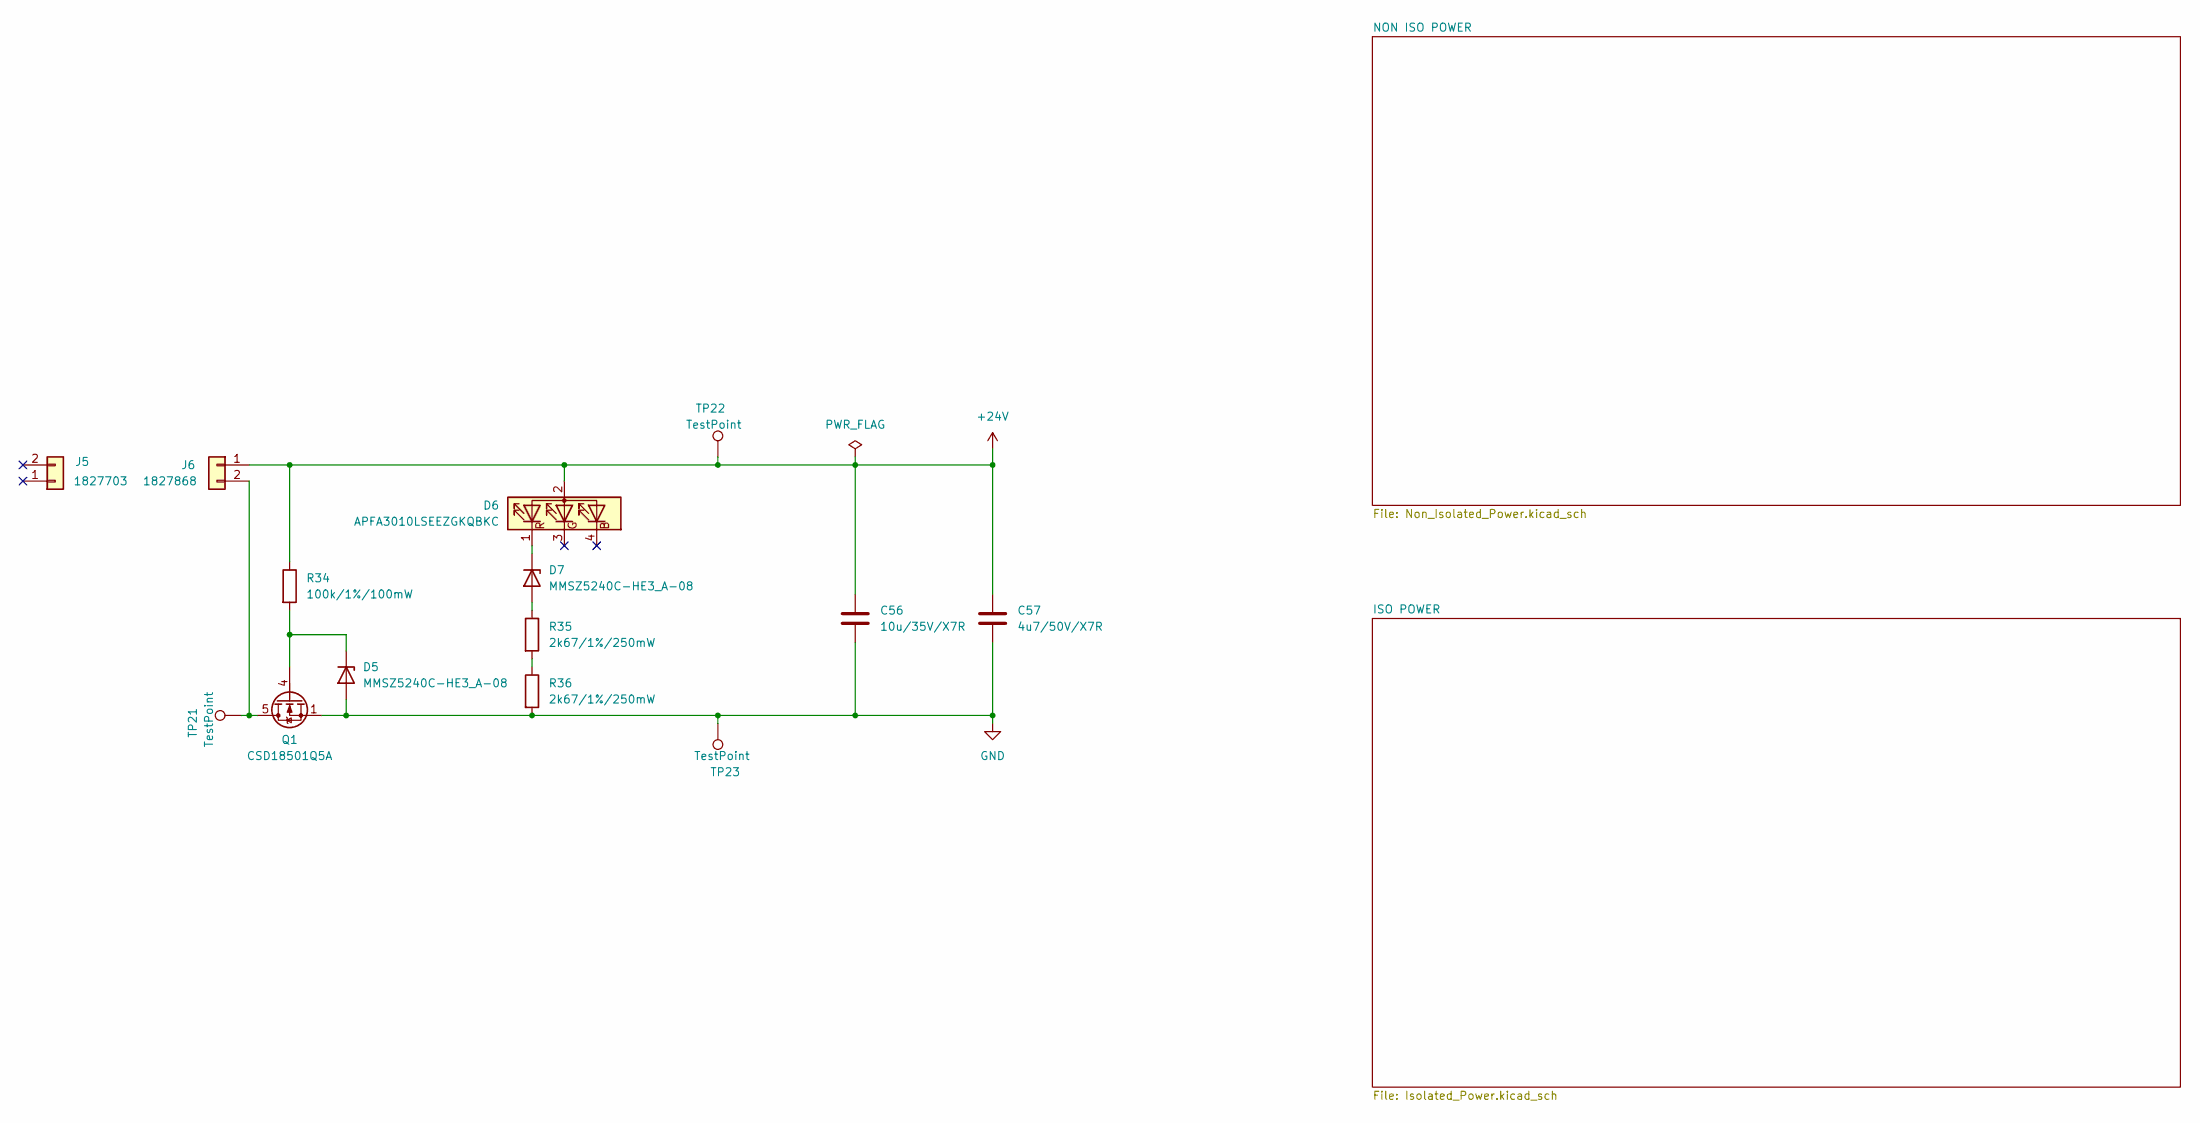
[picture p8: schematic Power.kicad_sch, ETH1CVOLT]

Parts:
C56: 10u/35V/X7R; C_1206_3216Metric_Pad1.33x1.80mm_HandSolder
C57: 4u7/50V/X7R; C_1206_3216Metric_Pad1.33x1.80mm_HandSolder
D5, D7: MMSZ5240C-HE3_A-08; D_SOD-123
D6: APFA3010LSEEZGKQBKC; LED_Kingbright_APFA3010_3x1.5mm_Horizontal
J5: 1827703
J6: 1827868; PhoenixContact_MC_1,5_2-GF-3.81_1x02_P3.81mm_Horizontal_Thr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
Q1: CSD18501Q5A; TDSON-8-1
R34: 100k/1%/100mW; R_0603_1608Metric_Pad0.98x0.95mm_HandSolder
R35, R36: 2k67/1%/250mW; R_0805_2012Metric_Pad1.20x1.40mm_HandSolder
TP21, TP22, TP23: TestPoint; TestPoint_Pad_D1.5mm

Connections:
+24V: C56.1, C57.1, D6.2 (A), J6.1, R34.1, TP22.1 (1_1); also elsewhere on the board
GND: C56.2, C57.2, D5.2 (A), Q1.1 (S), Q1.2 (S), Q1.3 (S), R36.2, TP23.1 (1_1); also elsewhere on the board
unnamed: D5.1 (K), Q1.4 (G), R34.2
unnamed: D6.1 (R), D7.1 (K)
unnamed: D7.2 (A), R35.1
unnamed: J6.2, Q1.5 (D), TP21.1 (1_1)
unnamed: R35.2, R36.1

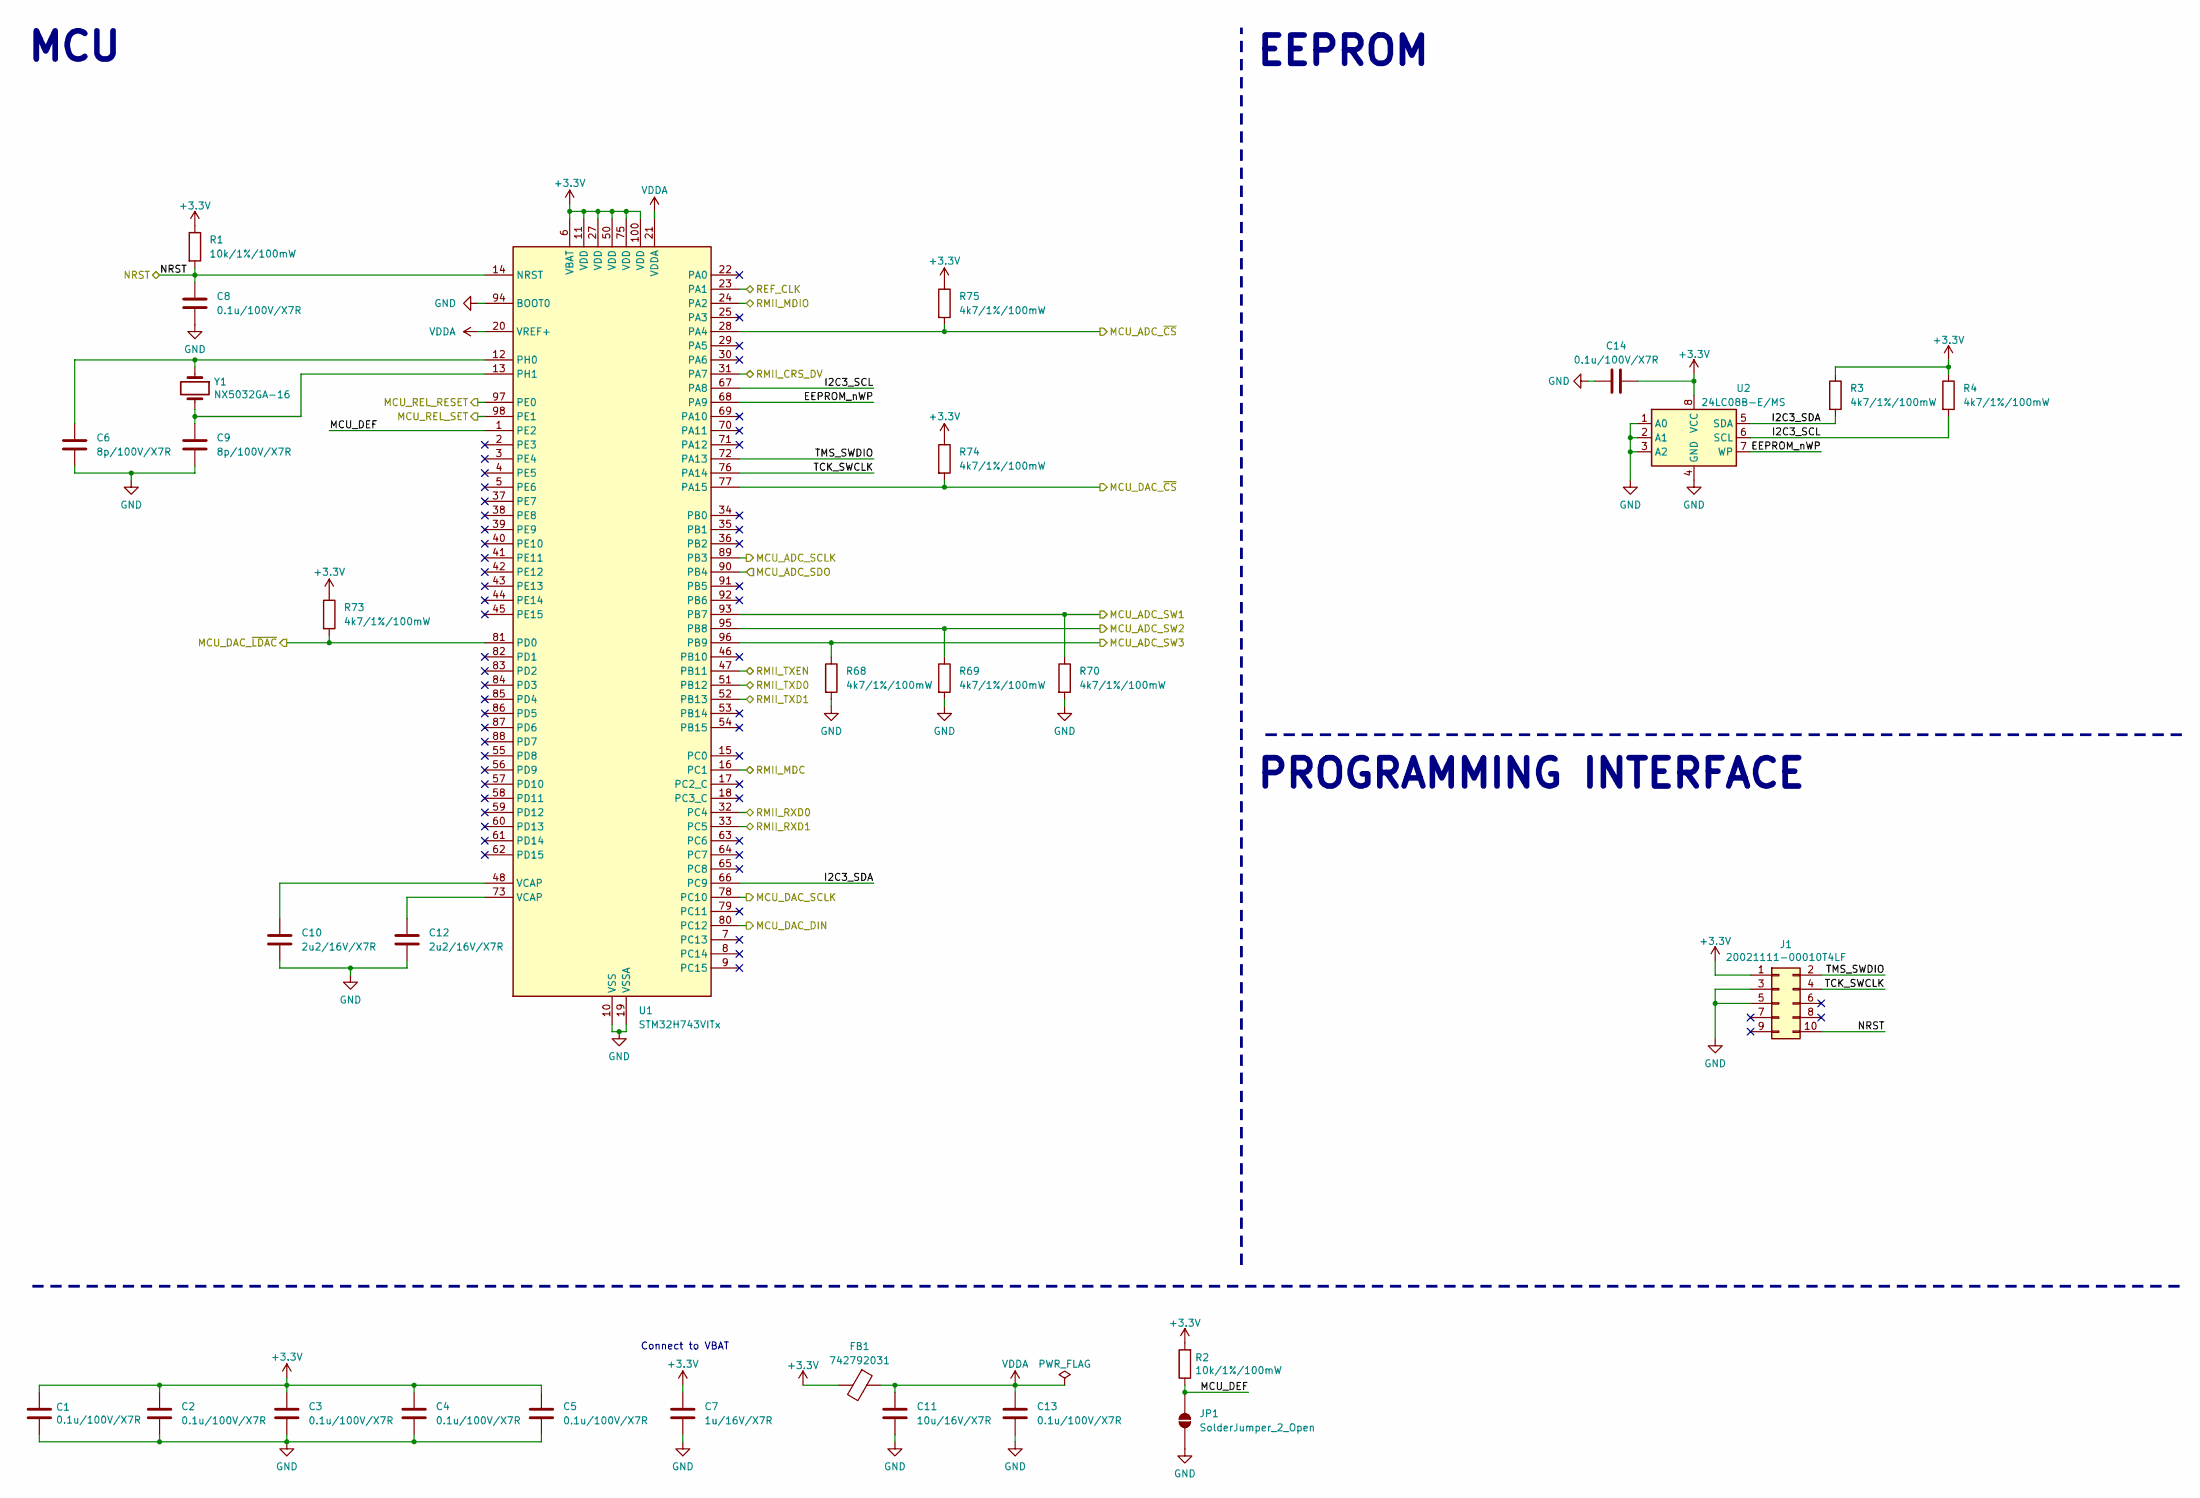
[picture p9: schematic MCU.kicad_sch, ETH1CVOLT]

Parts:
C1, C2, C3, C4, C5, C8, C13, C14: 0.1u/100V/X7R; C_0603_1608Metric_Pad1.08x0.95mm_HandSolder
C6, C9: 8p/100V/X7R; C_0603_1608Metric_Pad1.08x0.95mm_HandSolder
C7: 1u/16V/X7R; C_0603_1608Metric_Pad1.08x0.95mm_HandSolder
C10, C12: 2u2/16V/X7R; C_0603_1608Metric_Pad1.08x0.95mm_HandSolder
C11: 10u/16V/X7R; C_0805_2012Metric_Pad1.18x1.45mm_HandSolder
FB1: 742792031; L_0805_2012Metric_Pad1.05x1.20mm_HandSolder
J1: 20021111-00010T4LF; PinHeader_2x05_P1.27mm_Vertical
JP1: SolderJumper_2_Open; SolderJumper-2_P1.3mm_Open_Pad1.0x1.5mm
R1, R2: 10k/1%/100mW; R_0603_1608Metric_Pad0.98x0.95mm_HandSolder
R3, R4, R68, R69, R70, R73, R74, R75: 4k7/1%/100mW; R_0603_1608Metric_Pad0.98x0.95mm_HandSolder
U1: STM32H743VITx; LQFP-100_14x14mm_P0.5mm
U2: 24LC08B-E/MS; MSOP-8_3x3mm_P0.65mm
Y1: NX5032GA-16; NX5032GA

Connections:
+3.3V: C1.1, C2.1, C3.1, C4.1, C5.1, C7.1, C14.2, FB1.2, J1.1, R1.1, R2.2, R3.1, R4.1, R73.1, R74.1, R75.1, U1.6 (VBAT), U1.11 (VDD), U1.27 (VDD), U1.50 (VDD), U1.75 (VDD), U1.100 (VDD), U2.8 (VCC); also elsewhere on the board
/BLOCK DIAGRAM/ETHERNET/REF_CLK: U1.23 (PA1); also elsewhere on the board
/BLOCK DIAGRAM/ETHERNET/RMII_CRS_DV: U1.31 (PA7); also elsewhere on the board
/BLOCK DIAGRAM/ETHERNET/RMII_MDC: U1.16 (PC1); also elsewhere on the board
/BLOCK DIAGRAM/ETHERNET/RMII_MDIO: U1.24 (PA2); also elsewhere on the board
/BLOCK DIAGRAM/ETHERNET/RMII_RXD0: U1.32 (PC4); also elsewhere on the board
/BLOCK DIAGRAM/ETHERNET/RMII_RXD1: U1.33 (PC5); also elsewhere on the board
/BLOCK DIAGRAM/ETHERNET/RMII_TXD0: U1.51 (PB12); also elsewhere on the board
/BLOCK DIAGRAM/ETHERNET/RMII_TXD1: U1.52 (PB13); also elsewhere on the board
/BLOCK DIAGRAM/ETHERNET/RMII_TXEN: U1.47 (PB11); also elsewhere on the board
/BLOCK DIAGRAM/ISO DIG/MCU_ADC_SCLK: U1.89 (PB3); also elsewhere on the board
/BLOCK DIAGRAM/ISO DIG/MCU_ADC_SDO: U1.90 (PB4); also elsewhere on the board
/BLOCK DIAGRAM/ISO DIG/MCU_ADC_SW1: R70.1, U1.93 (PB7); also elsewhere on the board
/BLOCK DIAGRAM/ISO DIG/MCU_ADC_SW2: R69.1, U1.95 (PB8); also elsewhere on the board
/BLOCK DIAGRAM/ISO DIG/MCU_ADC_SW3: R68.1, U1.96 (PB9); also elsewhere on the board
/BLOCK DIAGRAM/ISO DIG/MCU_ADC_~CS: R75.2, U1.28 (PA4); also elsewhere on the board
/BLOCK DIAGRAM/ISO DIG/MCU_DAC_DIN: U1.80 (PC12); also elsewhere on the board
/BLOCK DIAGRAM/ISO DIG/MCU_DAC_SCLK: U1.78 (PC10); also elsewhere on the board
/BLOCK DIAGRAM/ISO DIG/MCU_DAC_~CS: R74.2, U1.77 (PA15); also elsewhere on the board
/BLOCK DIAGRAM/ISO DIG/MCU_DAC_~LDAC: R73.2, U1.81 (PD0); also elsewhere on the board
/BLOCK DIAGRAM/ISO DIG/MCU_REL_RESET: U1.97 (PE0); also elsewhere on the board
/BLOCK DIAGRAM/ISO DIG/MCU_REL_SET: U1.98 (PE1); also elsewhere on the board
/BLOCK DIAGRAM/MCU/EEPROM_nWP: U1.68 (PA9), U2.7 (WP)
/BLOCK DIAGRAM/MCU/I2C3_SCL: R4.2, U1.67 (PA8), U2.6 (SCL)
/BLOCK DIAGRAM/MCU/I2C3_SDA: R3.2, U1.66 (PC9), U2.5 (SDA)
/BLOCK DIAGRAM/MCU/MCU_DEF: JP1.2 (B), R2.1, U1.1 (PE2)
/BLOCK DIAGRAM/MCU/NRST: C8.1, J1.10, R1.2, U1.14 (NRST); also elsewhere on the board
/BLOCK DIAGRAM/MCU/TCK_SWCLK: J1.4, U1.76 (PA14)
/BLOCK DIAGRAM/MCU/TMS_SWDIO: J1.2, U1.72 (PA13)
GND: C1.2, C2.2, C3.2, C4.2, C5.2, C6.2, C7.2, C8.2, C9.2, C10.2, C11.2, C12.2, C13.2, C14.1, J1.3, J1.5, JP1.1 (A), R68.2, R69.2, R70.2, U1.10 (VSS), U1.19 (VSSA), U1.26 (VSS), U1.49 (VSS), U1.74 (VSS), U1.94 (BOOT0), U1.99 (VSS), U2.1 (A0), U2.2 (A1), U2.3 (A2), U2.4 (GND); also elsewhere on the board
unnamed: C10.1, U1.48 (VCAP)
unnamed: C12.1, U1.73 (VCAP)
unnamed: C6.1, U1.12 (PH0), Y1.1
unnamed: C9.1, U1.13 (PH1), Y1.2
VDDA: C11.1, C13.1, FB1.1, U1.20 (VREF+), U1.21 (VDDA)

Notes on the sheet:
MCU
EEPROM
Connect to VBAT
PROGRAMMING INTERFACE

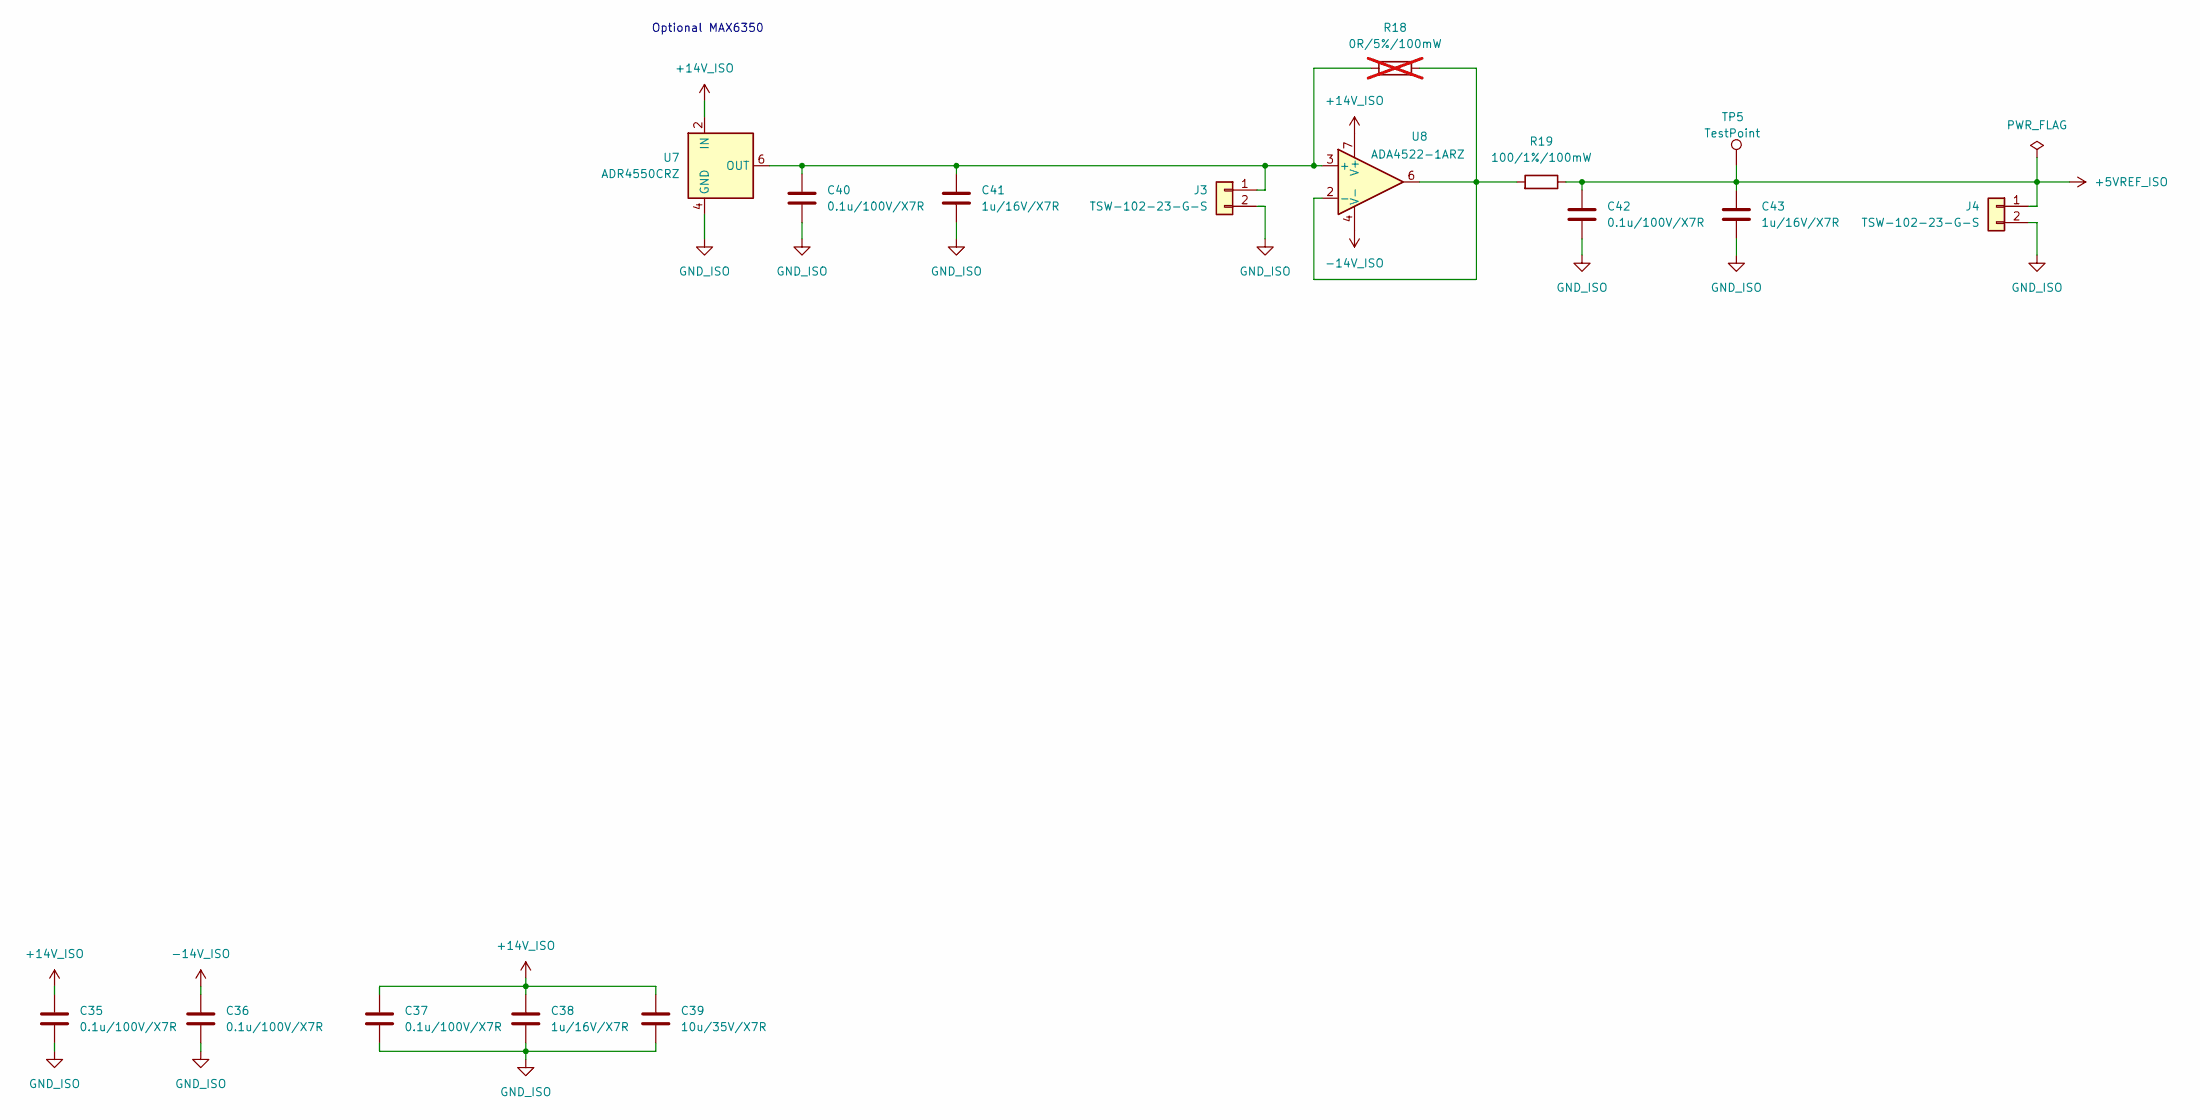
[picture p10: schematic Voltage_Reference.kicad_sch, ETH1CVOLT]

Parts:
C35, C36, C37, C40, C42: 0.1u/100V/X7R; C_0603_1608Metric_Pad1.08x0.95mm_HandSolder
C38, C41, C43: 1u/16V/X7R; C_0603_1608Metric_Pad1.08x0.95mm_HandSolder
C39: 10u/35V/X7R; C_1206_3216Metric_Pad1.33x1.80mm_HandSolder
J3, J4: TSW-102-23-G-S; PinHeader_1x02_P2.54mm_Vertical
R18: 0R/5%/100mW; R_0603_1608Metric_Pad0.98x0.95mm_HandSolder; not fitted
R19: 100/1%/100mW; R_0603_1608Metric_Pad0.98x0.95mm_HandSolder
TP5: TestPoint; TestPoint_Pad_D1.5mm
U7: ADR4550CRZ; SOIC-8_3.9x4.9mm_P1.27mm
U8: ADA4522-1ARZ; SOIC-8_3.9x4.9mm_P1.27mm

Connections:
+5VREF_ISO: C42.1, C43.1, J4.1, R19.1, TP5.1 (1_1); also elsewhere on the board
+14V_ISO: C35.1, C37.1, C38.1, C39.1, U7.2 (IN), U8.7 (V+); also elsewhere on the board
-14V_ISO: C36.1, U8.4 (V-); also elsewhere on the board
GND_ISO: C35.2, C36.2, C37.2, C38.2, C39.2, C40.2, C41.2, C42.2, C43.2, J3.2, J4.2, U7.4 (GND); also elsewhere on the board
unnamed: C40.1, C41.1, J3.1, R18.1, U7.6 (OUT), U8.3 (+)
unnamed: R18.2, R19.2, U8.2 (-), U8.6

Notes on the sheet:
Optional MAX6350

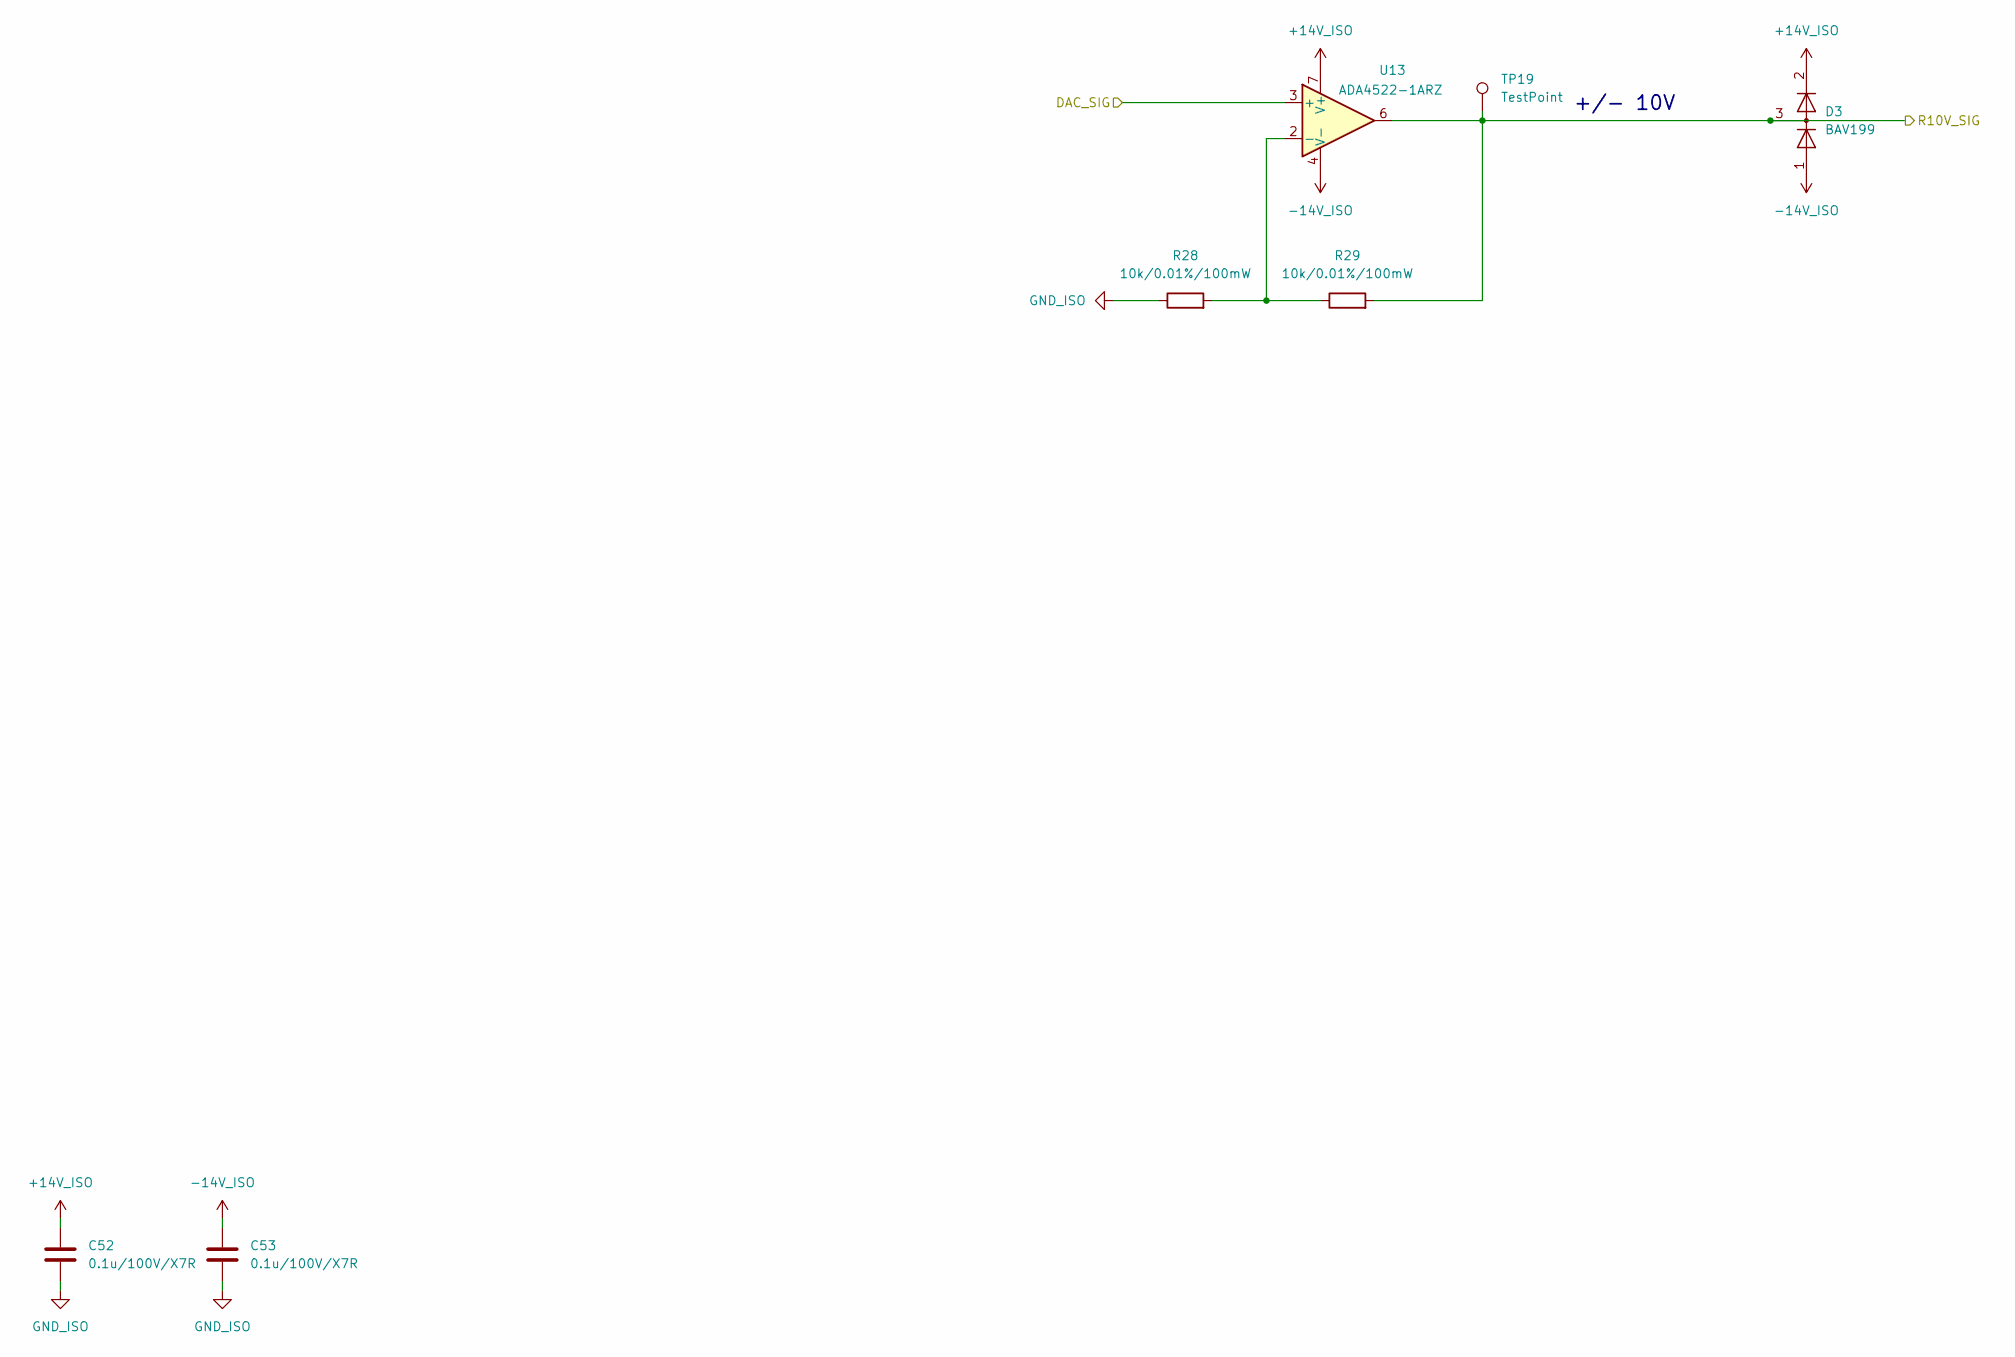
[picture p11: schematic Range_10V.kicad_sch, ETH1CVOLT]

Parts:
C52, C53: 0.1u/100V/X7R; C_0603_1608Metric_Pad1.08x0.95mm_HandSolder
D3: BAV199; SOT-23
R28, R29: 10k/0.01%/100mW; R_0603_1608Metric_Pad0.98x0.95mm_HandSolder
TP19: TestPoint; TestPoint_Pad_D1.5mm
U13: ADA4522-1ARZ; SOIC-8_3.9x4.9mm_P1.27mm

Connections:
+14V_ISO: C52.1, D3.2 (A), U13.7 (V+); also elsewhere on the board
-14V_ISO: C53.1, D3.1 (K), U13.4 (V-); also elsewhere on the board
/BLOCK DIAGRAM/DAC/DAC_SIG: U13.3 (+); also elsewhere on the board
/BLOCK DIAGRAM/OUTPUT/R10V_SIG: D3.3 (K), R29.2, TP19.1 (1_1), U13.6; also elsewhere on the board
GND_ISO: C52.2, C53.2, R28.1; also elsewhere on the board
unnamed: R28.2, R29.1, U13.2 (-)

Notes on the sheet:
+/- 10V
