BehrensG/ETH1CVOLT/HARDWARE/ETH1CVOLT/ETH1CVOLT.kicad_pcb

## KiCad design HARDWARE/ETH1CVOLT/ETH1CVOLT.kicad_pcb (continued)

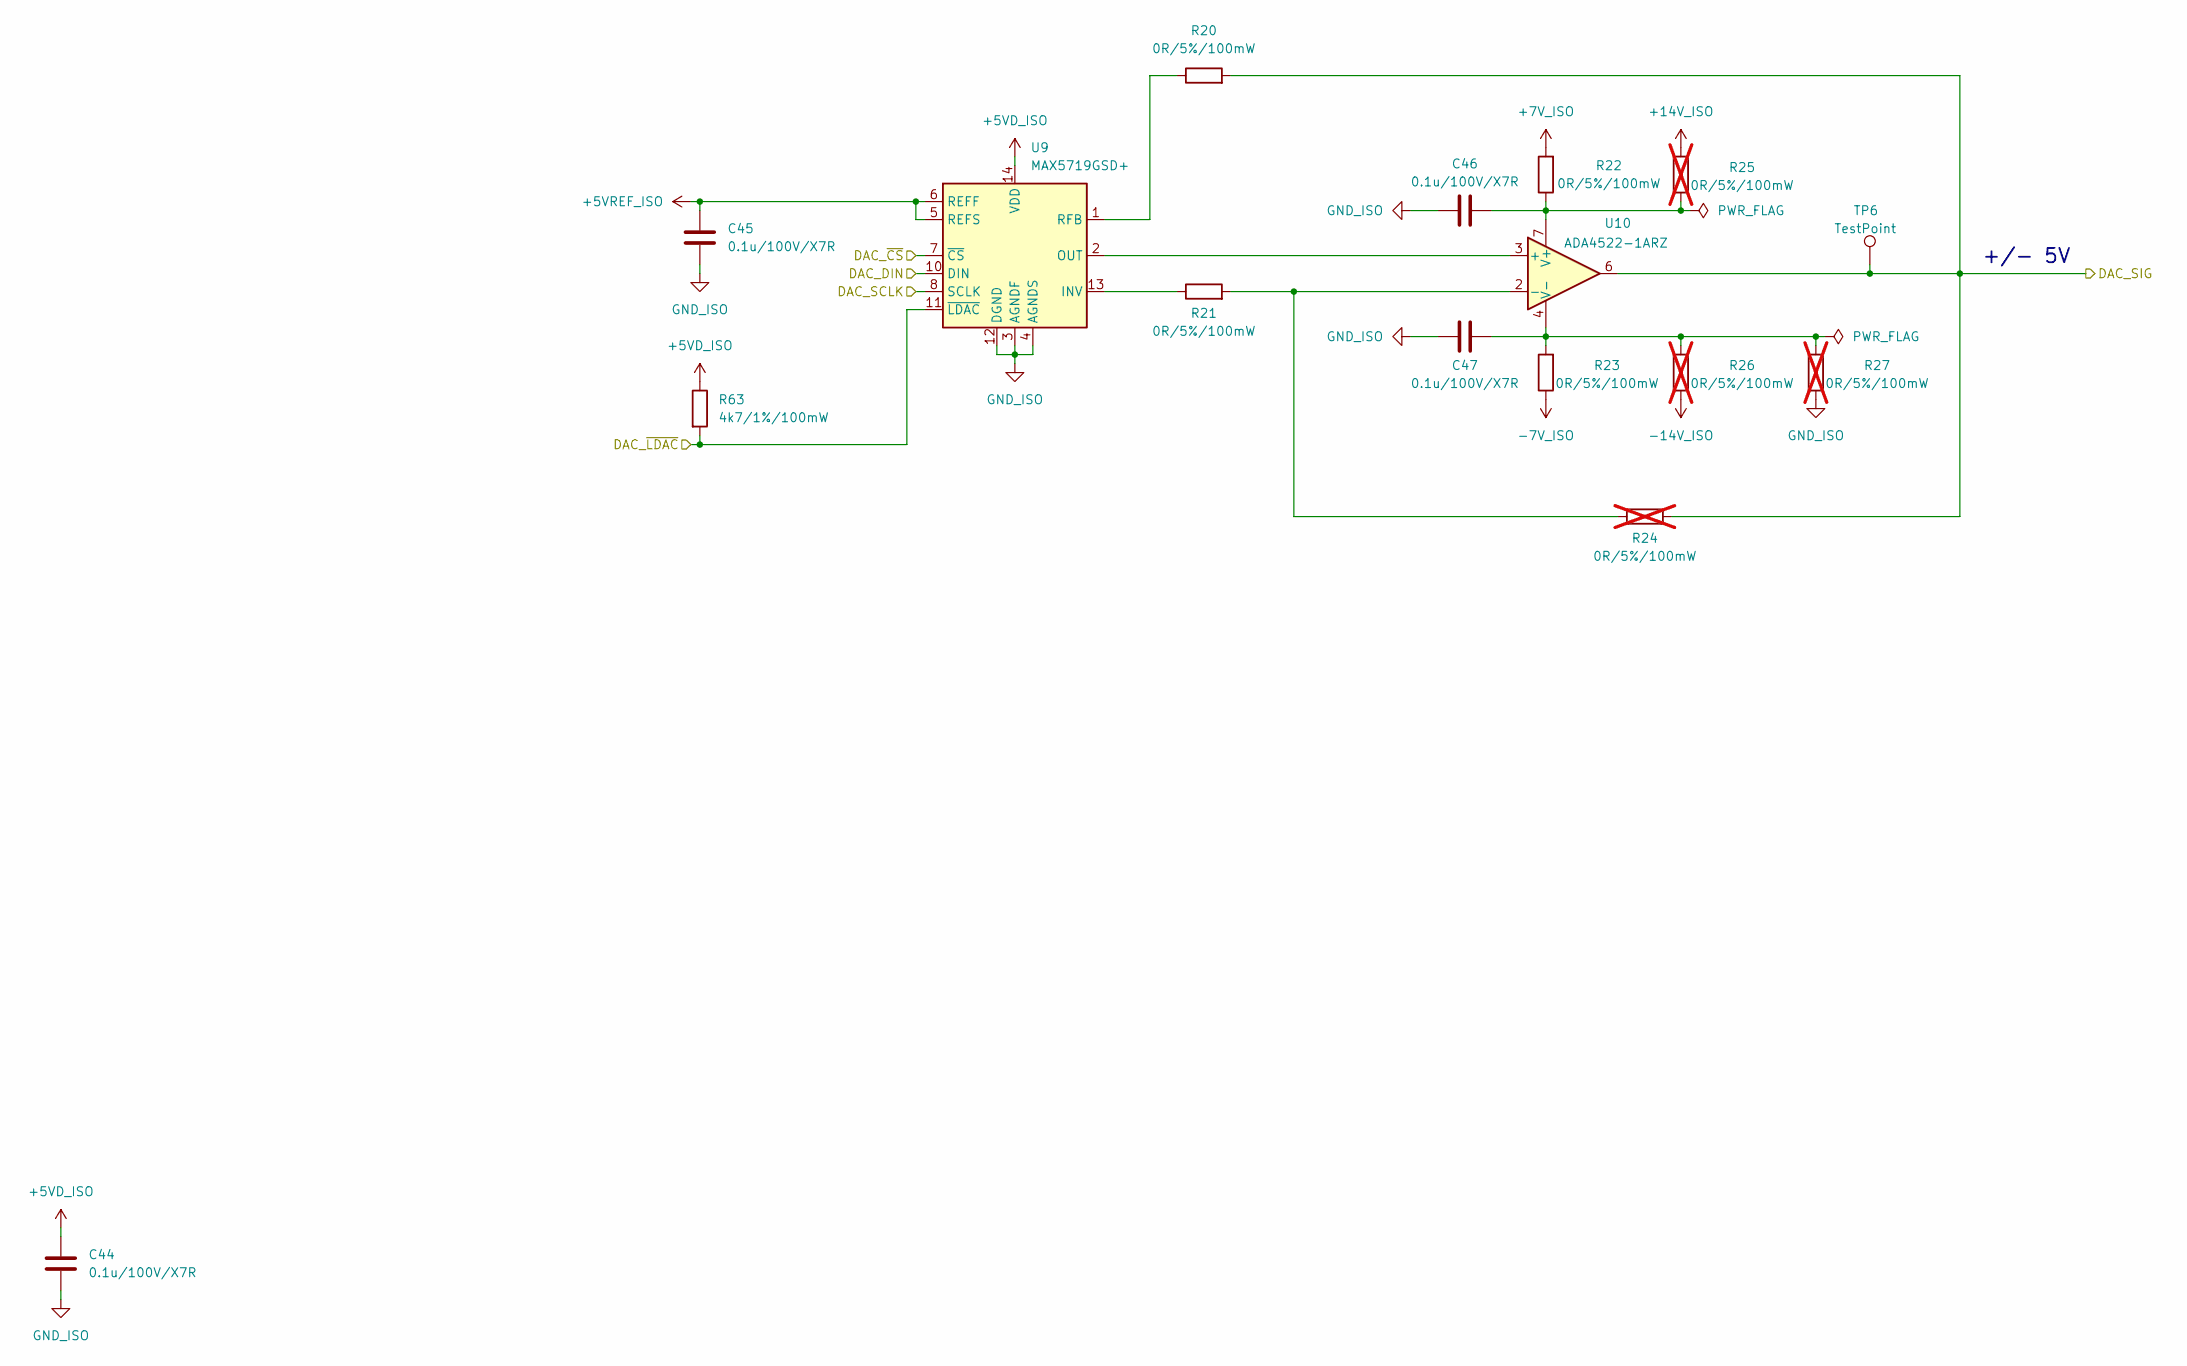
[picture p12: schematic DAC.kicad_sch, ETH1CVOLT]

Parts:
C44, C45, C46, C47: 0.1u/100V/X7R; C_0603_1608Metric_Pad1.08x0.95mm_HandSolder
R20, R21, R22, R23: 0R/5%/100mW; R_0603_1608Metric_Pad0.98x0.95mm_HandSolder
R24, R25, R26, R27: 0R/5%/100mW; R_0603_1608Metric_Pad0.98x0.95mm_HandSolder; not fitted
R63: 4k7/1%/100mW; R_0603_1608Metric_Pad0.98x0.95mm_HandSolder
TP6: TestPoint; TestPoint_Pad_D1.5mm
U9: MAX5719GSD+; SOIC-14_3.9x8.7mm_P1.27mm
U10: ADA4522-1ARZ; SOIC-8_3.9x4.9mm_P1.27mm

Connections:
+5VD_ISO: C44.1, R63.1, U9.14 (VDD); also elsewhere on the board
+5VREF_ISO: C45.1, U9.5 (REFS), U9.6 (REFF); also elsewhere on the board
+7V_ISO: R22.2; also elsewhere on the board
+14V_ISO: R25.2; also elsewhere on the board
-7V_ISO: R23.1; also elsewhere on the board
-14V_ISO: R26.1; also elsewhere on the board
/BLOCK DIAGRAM/DAC/DAC_DIN: U9.10 (DIN); also elsewhere on the board
/BLOCK DIAGRAM/DAC/DAC_SCLK: U9.8 (SCLK); also elsewhere on the board
/BLOCK DIAGRAM/DAC/DAC_SIG: R20.2, R24.2, TP6.1 (1_1), U10.6; also elsewhere on the board
/BLOCK DIAGRAM/DAC/DAC_~CS: U9.7 (~CS); also elsewhere on the board
/BLOCK DIAGRAM/DAC/DAC_~LDAC: R63.2, U9.11 (~LDAC); also elsewhere on the board
GND_ISO: C44.2, C45.2, C46.1, C47.1, R27.1, U9.3 (AGNDF), U9.4 (AGNDS), U9.12 (DGND); also elsewhere on the board
unnamed: R21.1, U9.13 (INV)
unnamed: R20.1, U9.1 (RFB)
unnamed: U9.2 (OUT), U10.3 (+)
unnamed: R21.2, R24.1, U10.2 (-)
unnamed: C46.2, R22.1, R25.1, U10.7 (V+)
unnamed: C47.2, R23.2, R26.2, R27.2, U10.4 (V-)

Notes on the sheet:
+/- 5V

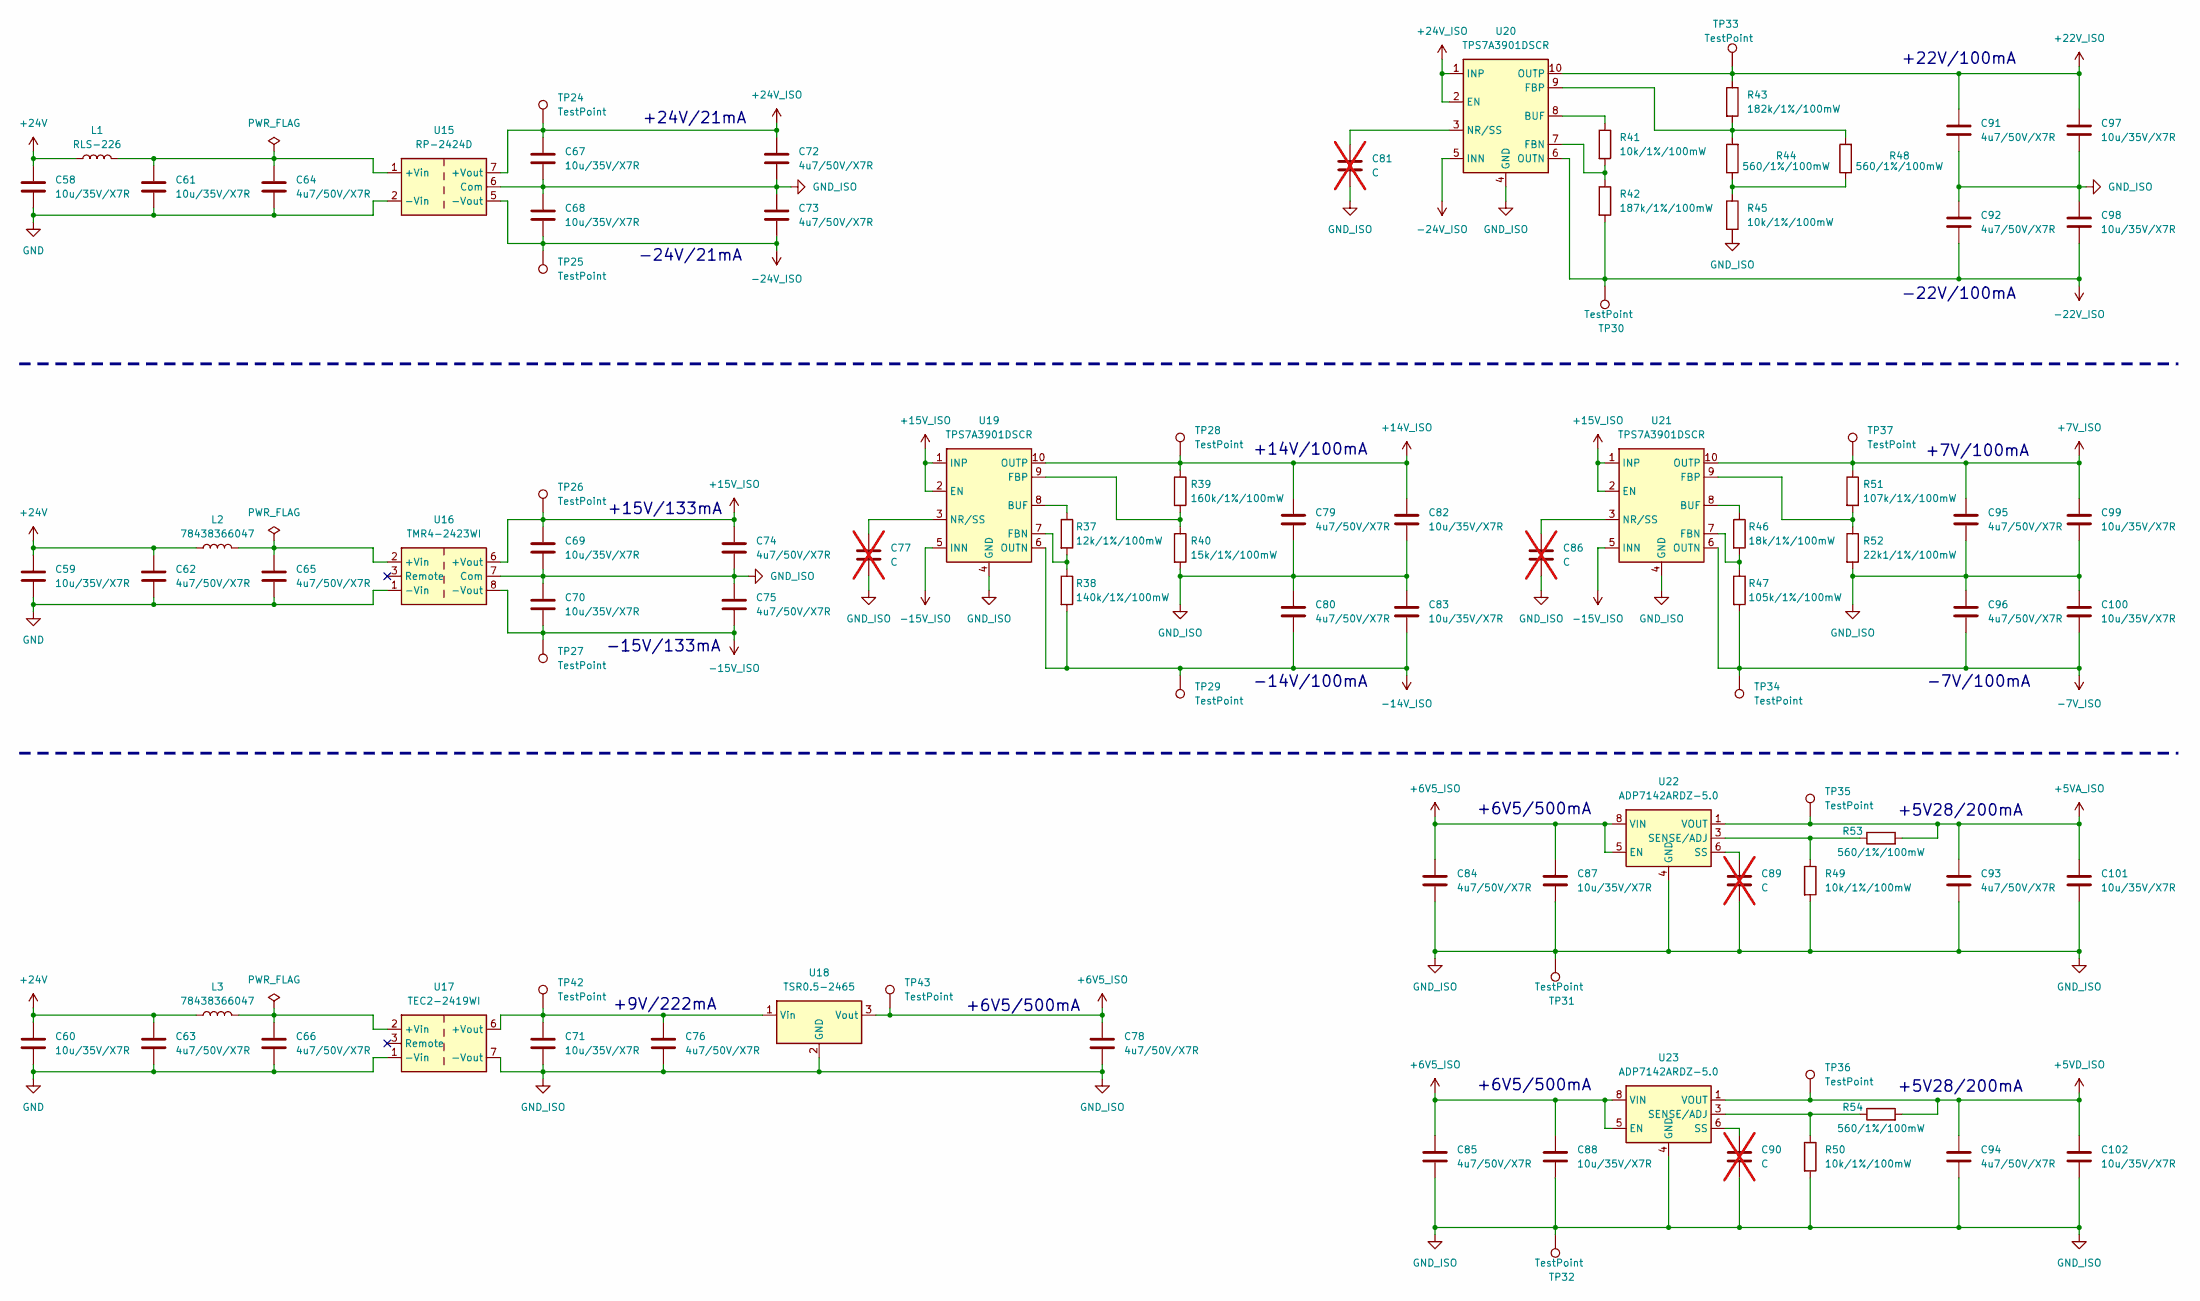
[picture p13: schematic Isolated_Power.kicad_sch, ETH1CVOLT]

Parts:
C58, C59, C60, C61, C67, C68, C69, C70, C71, C82, C83, C87, C88, C97, C98, C99, C100, C101, C102: 10u/35V/X7R; C_1206_3216Metric_Pad1.33x1.80mm_HandSolder
C62, C63, C64, C65, C66, C72, C73, C74, C75, C76, C78, C79, C80, C84, C85, C91, C92, C93, C94, C95, C96: 4u7/50V/X7R; C_1206_3216Metric_Pad1.33x1.80mm_HandSolder
C77, C81, C86, C89, C90: C; C_0603_1608Metric_Pad1.08x0.95mm_HandSolder; not fitted
L1: RLS-226
L2, L3: 78438366047
R37: 12k/1%/100mW; R_0603_1608Metric_Pad0.98x0.95mm_HandSolder
R38: 140k/1%/100mW; R_0603_1608Metric_Pad0.98x0.95mm_HandSolder
R39: 160k/1%/100mW; R_0603_1608Metric_Pad0.98x0.95mm_HandSolder
R40: 15k/1%/100mW; R_0603_1608Metric_Pad0.98x0.95mm_HandSolder
R41, R45, R49, R50: 10k/1%/100mW; R_0603_1608Metric_Pad0.98x0.95mm_HandSolder
R42: 187k/1%/100mW; R_0603_1608Metric_Pad0.98x0.95mm_HandSolder
R43: 182k/1%/100mW; R_0603_1608Metric_Pad0.98x0.95mm_HandSolder
R44, R48, R53, R54: 560/1%/100mW; R_0603_1608Metric_Pad0.98x0.95mm_HandSolder
R46: 18k/1%/100mW; R_0603_1608Metric_Pad0.98x0.95mm_HandSolder
R47: 105k/1%/100mW; R_0603_1608Metric_Pad0.98x0.95mm_HandSolder
R51: 107k/1%/100mW; R_0603_1608Metric_Pad0.98x0.95mm_HandSolder
R52: 22k1/1%/100mW; R_0603_1608Metric_Pad0.98x0.95mm_HandSolder
TP24, TP25, TP26, TP27, TP28, TP29, TP30, TP31, TP32, TP33, TP34, TP35, TP36, TP37, TP42, TP43: TestPoint; TestPoint_Pad_D1.5mm
U15: RP-2424D; RP-xxxxD
U16: TMR4-2423WI; Converter_DCDC_TRACO_TMR4-xxxxWI_THT
U17: TEC2-2419WI; Converter_DCDC_TRACO_TEC2-12xxWI_24xxWI_48xxWI_THT
U18: TSR0.5-2465; Converter_DCDC_TRACO_TSR0.5-24xx_TSR0.5-24xxx_THT
U19, U20, U21: TPS7A3901DSCR; Texas_S-PVSON-N10_ThermalVias
U22, U23: ADP7142ARDZ-5.0; SOIC-8-1EP_3.9x4.9mm_P1.27mm_EP2.29x3mm

Connections:
+5VA_ISO: C93.1, C101.1, R53.2, TP35.1 (1_1), U22.1 (VOUT), U22.2 (VOUT); also elsewhere on the board
+5VD_ISO: C94.1, C102.1, R54.2, TP36.1 (1_1), U23.1 (VOUT), U23.2 (VOUT); also elsewhere on the board
+6V5_ISO: C78.1, C84.1, C85.1, C87.1, C88.1, TP43.1 (1_1), U18.3 (Vout), U22.5 (EN), U22.7 (VIN), U22.8 (VIN), U23.5 (EN), U23.7 (VIN), U23.8 (VIN)
+7V_ISO: C95.1, C99.1, R51.1, TP37.1 (1_1), U21.10 (OUTP); also elsewhere on the board
+14V_ISO: C79.1, C82.1, R39.1, TP28.1 (1_1), U19.10 (OUTP); also elsewhere on the board
+15V_ISO: C69.1, C74.1, TP26.1 (1_1), U16.6 (+Vout), U19.1 (INP), U19.2 (EN), U21.1 (INP), U21.2 (EN)
+22V_ISO: C91.1, C97.1, R43.1, TP33.1 (1_1), U20.10 (OUTP); also elsewhere on the board
+24V: C58.1, C59.1, C60.1, C62.1, C63.1, L1.1, L2.1, L3.1; also elsewhere on the board
+24V_ISO: C67.1, C72.1, TP24.1 (1_1), U15.7 (+Vout), U20.1 (INP), U20.2 (EN)
-7V_ISO: C96.2, C100.2, R47.2, TP34.1 (1_1), U21.6 (OUTN); also elsewhere on the board
-14V_ISO: C80.2, C83.2, R38.2, TP29.1 (1_1), U19.6 (OUTN); also elsewhere on the board
-15V_ISO: C70.2, C75.2, TP27.1 (1_1), U16.8 (-Vout), U19.5 (INN), U21.5 (INN)
-22V_ISO: C92.2, C98.2, R42.2, TP30.1 (1_1), U20.6 (OUTN); also elsewhere on the board
-24V_ISO: C68.2, C73.2, TP25.1 (1_1), U15.5 (-Vout), U20.5 (INN)
GND: C58.2, C59.2, C60.2, C61.2, C62.2, C63.2, C64.2, C65.2, C66.2, U15.2 (-Vin), U16.1 (-Vin), U17.1 (-Vin); also elsewhere on the board
GND_ISO: C67.2, C68.1, C69.2, C70.1, C71.2, C72.2, C73.1, C74.2, C75.1, C76.2, C77.2, C78.2, C79.2, C80.1, C81.2, C82.2, C83.1, C84.2, C85.2, C86.2, C87.2, C88.2, C89.2, C90.2, C91.2, C92.1, C93.2, C94.2, C95.2, C96.1, C97.2, C98.1, C99.2, C100.1, C101.2, C102.2, R40.2, R45.2, R49.2, R50.2, R52.2, TP31.1 (1_1), TP32.1 (1_1), U15.6 (Com), U16.7 (Com), U17.7 (-Vout), U18.2 (GND), U19.4 (GND), U19.11 (GND), U20.4 (GND), U20.11 (GND), U21.4 (GND), U21.11 (GND), U22.4 (GND), U22.9 (GND), U23.4 (GND), U23.9 (GND); also elsewhere on the board
unnamed: R44.1, R45.1, R48.1
unnamed: C61.1, C64.1, L1.2, U15.1 (+Vin)
unnamed: C65.1, L2.2, U16.2 (+Vin)
unnamed: C66.1, L3.2, U17.2 (+Vin)
unnamed: C71.1, C76.1, TP42.1 (1_1), U17.6 (+Vout), U18.1 (Vin)
unnamed: R37.1, U19.8 (BUF)
unnamed: R37.2, R38.1, U19.7 (FBN)
unnamed: R39.2, R40.1, U19.9 (FBP)
unnamed: C77.1, U19.3 (NR/SS)
unnamed: R41.1, U20.8 (BUF)
unnamed: R41.2, R42.1, U20.7 (FBN)
unnamed: R43.2, R44.2, R48.2, U20.9 (FBP)
unnamed: C81.1, U20.3 (NR/SS)
unnamed: R46.1, U21.8 (BUF)
unnamed: R46.2, R47.1, U21.7 (FBN)
unnamed: R51.2, R52.1, U21.9 (FBP)
unnamed: C86.1, U21.3 (NR/SS)
unnamed: R49.1, R53.1, U22.3 (SENSE/ADJ)
unnamed: C89.1, U22.6 (SS)
unnamed: R50.1, R54.1, U23.3 (SENSE/ADJ)
unnamed: C90.1, U23.6 (SS)

Notes on the sheet:
-7V/100mA
+6V5/500mA
+22V/100mA
-24V/21mA
+24V/21mA
+15V/133mA
+9V/222mA
-14V/100mA
-22V/100mA
+14V/100mA
+5V28/200mA
-15V/133mA
+7V/100mA

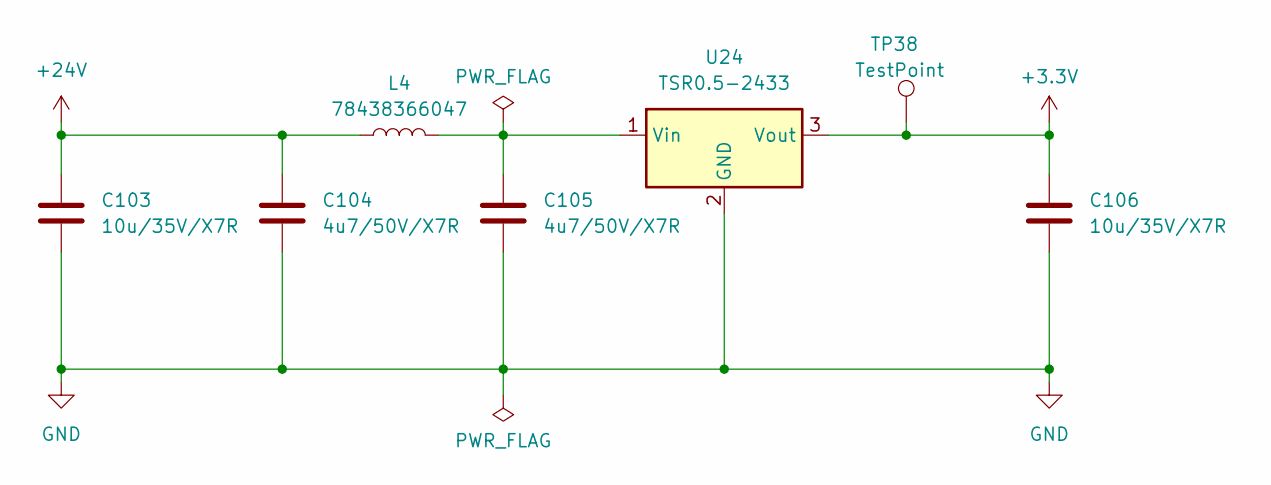
[picture p14: schematic Non_Isolated_Power.kicad_sch, ETH1CVOLT]

Parts:
C103, C106: 10u/35V/X7R; C_1206_3216Metric_Pad1.33x1.80mm_HandSolder
C104, C105: 4u7/50V/X7R; C_1206_3216Metric_Pad1.33x1.80mm_HandSolder
L4: 78438366047
TP38: TestPoint; TestPoint_Pad_D1.5mm
U24: TSR0.5-2433; Converter_DCDC_TRACO_TSR0.5-24xx_TSR0.5-24xxx_THT

Connections:
+3.3V: C106.1, TP38.1 (1_1), U24.3 (Vout); also elsewhere on the board
+24V: C103.1, C104.1, L4.1; also elsewhere on the board
GND: C103.2, C104.2, C105.2, C106.2, U24.2 (GND); also elsewhere on the board
unnamed: C105.1, L4.2, U24.1 (Vin)

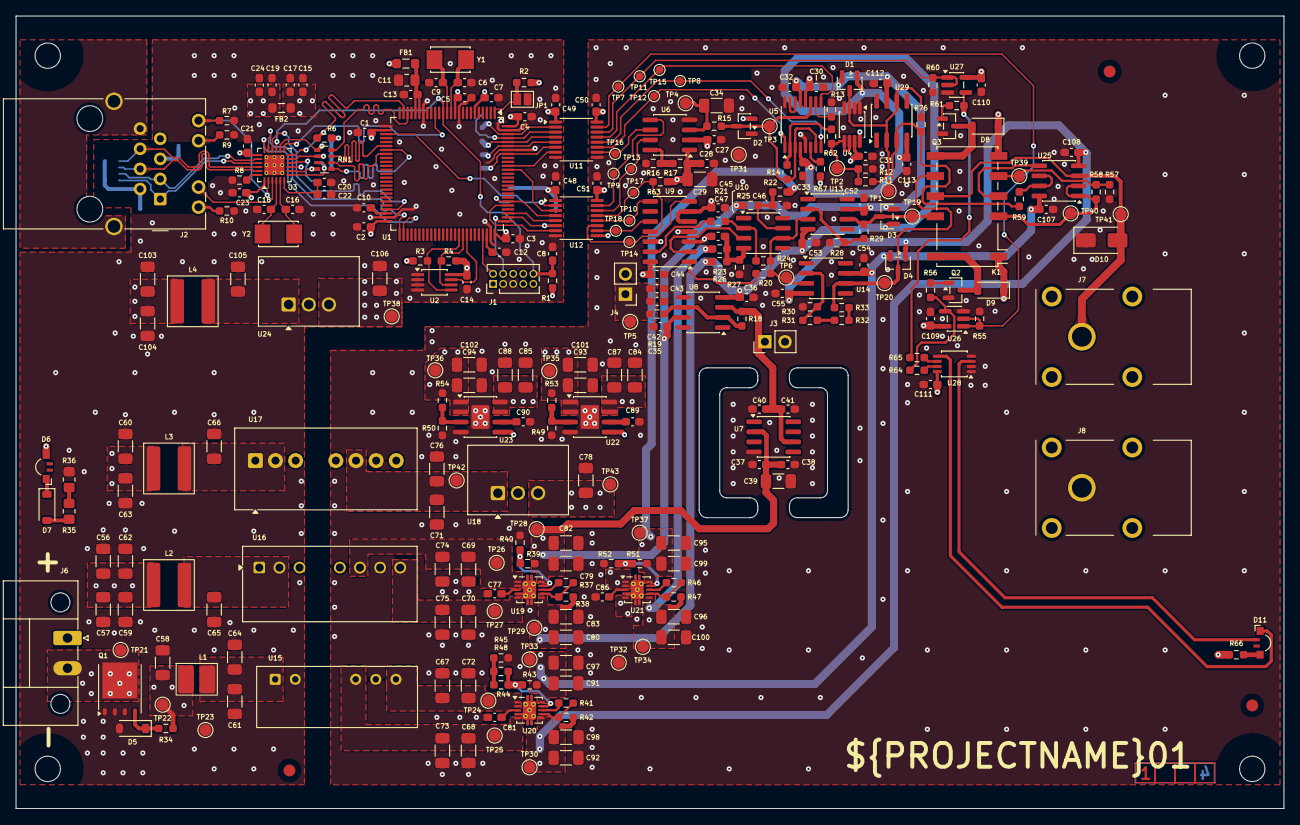
[picture p15: board ETH1CVOLT.kicad_pcb from above]

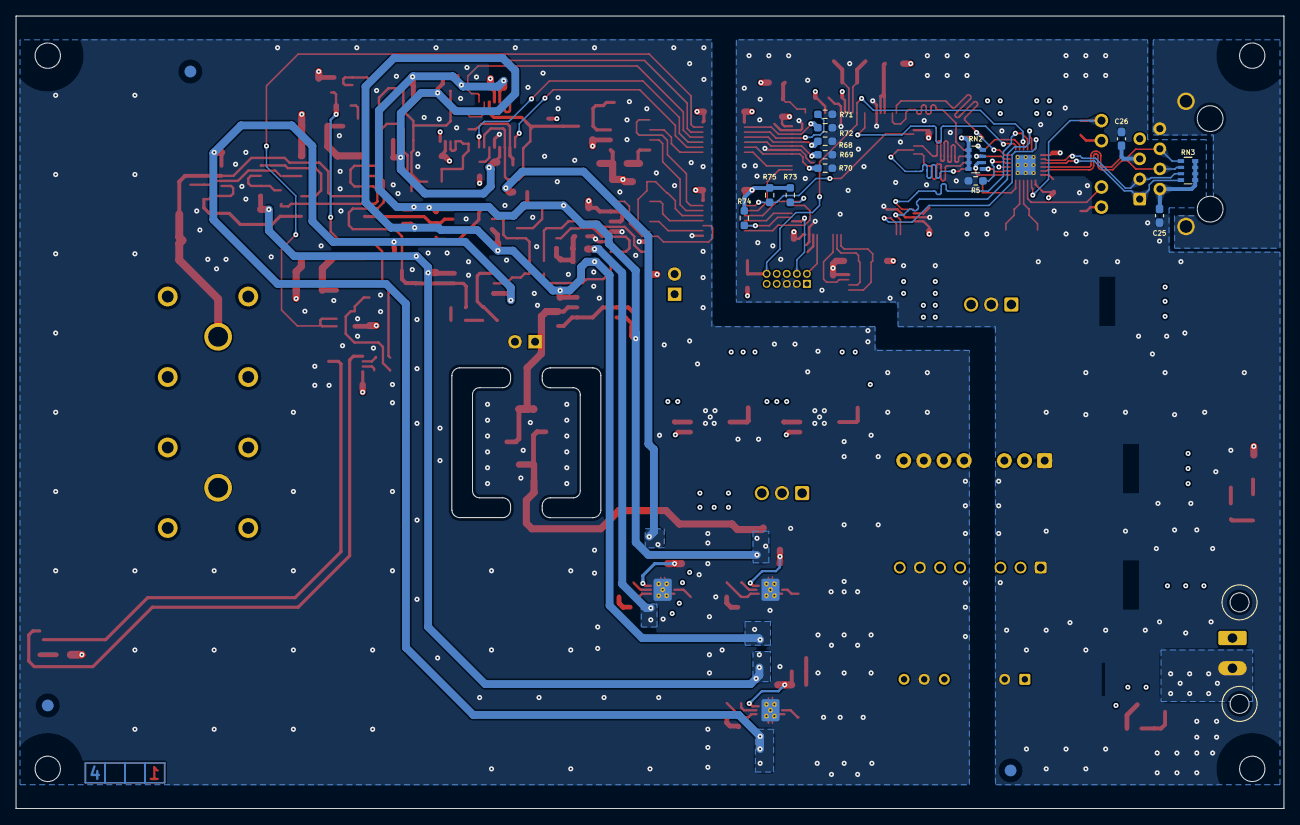
[picture p16: board ETH1CVOLT.kicad_pcb from below]

Board: 4 copper layers, 160.0 x 100.0 mm, 305 parts (16 on the bottom side), 150 nets.
