BehrensG/ETH1CVOLT/SOFTWARE/IDE/ETH1CVOLT/NetXDuo/App/app_netxduo.h

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
/* Define to prevent recursive inclusion -------------------------------------*/
#ifndef __APP_NETXDUO_H__
#define __APP_NETXDUO_H__

#ifdef __cplusplus
extern "C" {
#endif

/* Includes ------------------------------------------------------------------*/
#include "nx_api.h"

#include "nx_stm32_eth_driver.h"

/* Exported types ------------------------------------------------------------*/
/* Exported constants --------------------------------------------------------*/
/* The DEFAULT_PAYLOAD_SIZE should match with RxBuffLen configured via MX_ETH_Init */
#ifndef DEFAULT_PAYLOAD_SIZE
#define DEFAULT_PAYLOAD_SIZE      1536
#endif

#ifndef DEFAULT_ARP_CACHE_SIZE
#define DEFAULT_ARP_CACHE_SIZE    1024
#endif

/* Exported macro ------------------------------------------------------------*/
/* Exported functions prototypes ---------------------------------------------*/
UINT MX_NetXDuo_Init(VOID *memory_ptr);

#define NX_APP_DEFAULT_TIMEOUT               (10 * NX_IP_PERIODIC_RATE)

#define NX_APP_PACKET_POOL_SIZE              ((DEFAULT_PAYLOAD_SIZE + sizeof(NX_PACKET)) * 15)

#define NX_APP_THREAD_STACK_SIZE             1024

#define Nx_IP_INSTANCE_THREAD_SIZE           1024

#define NX_APP_THREAD_PRIORITY               10

#ifndef NX_APP_INSTANCE_PRIORITY
#define NX_APP_INSTANCE_PRIORITY             NX_APP_THREAD_PRIORITY
#endif

#define NX_APP_DEFAULT_IP_ADDRESS                   IP_ADDRESS(192, 168, 1, 12)

#define NX_APP_DEFAULT_NET_MASK                     IP_ADDRESS(255, 255, 255, 0)

#ifdef __cplusplus
}
#endif
#endif /* __APP_NETXDUO_H__ */
