BehrensG/ETH1CVOLT/SOFTWARE/IDE/ETH1CVOLT/Core/Inc/main.h

#define MCU_DEF_Pin LL_GPIO_PIN_2
#define MCU_DEF_GPIO_Port GPIOE
#define MCU_ADC_NSS_Pin LL_GPIO_PIN_4
#define MCU_ADC_NSS_GPIO_Port GPIOA
#define EEPROM_nWR_Pin LL_GPIO_PIN_9
#define EEPROM_nWR_GPIO_Port GPIOA
#define MCU_DAC_nCS_Pin LL_GPIO_PIN_15
#define MCU_DAC_nCS_GPIO_Port GPIOA
#define MCU_DAC_SCLK_Pin LL_GPIO_PIN_10
#define MCU_DAC_SCLK_GPIO_Port GPIOC
#define MCU_DAC_DIN_Pin LL_GPIO_PIN_12
#define MCU_DAC_DIN_GPIO_Port GPIOC
#define MCU_DAC_nLDAC_Pin LL_GPIO_PIN_0
#define MCU_DAC_nLDAC_GPIO_Port GPIOD
#define MCU_ADC_SCLK_Pin LL_GPIO_PIN_3
#define MCU_ADC_SCLK_GPIO_Port GPIOB
#define MCU_ADC_SDO_Pin LL_GPIO_PIN_4
#define MCU_ADC_SDO_GPIO_Port GPIOB
#define MCU_ADC_SW1_Pin LL_GPIO_PIN_7
#define MCU_ADC_SW1_GPIO_Port GPIOB
#define MCU_ADC_SW2_Pin LL_GPIO_PIN_8
#define MCU_ADC_SW2_GPIO_Port GPIOB
#define MCU_ADC_SW3_Pin LL_GPIO_PIN_9
#define MCU_ADC_SW3_GPIO_Port GPIOB
#define MCU_REL_RESET_Pin LL_GPIO_PIN_0
#define MCU_REL_RESET_GPIO_Port GPIOE
#define MCU_REL_SET_Pin LL_GPIO_PIN_1
#define MCU_REL_SET_GPIO_Port GPIOE
