BehrensG/ETH1CVOLT/SOFTWARE/IDE/ETH1CVOLT/NetXDuo/App/app_netxduo.c

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

/* Includes ------------------------------------------------------------------*/
#include "app_netxduo.h"

/* USER CODE BEGIN Includes */
#include "nxd_bsd.h"
/* USER CODE END Includes */

TX_THREAD      NxAppThread;
NX_PACKET_POOL NxAppPool;
NX_IP          NetXDuoEthIpInstance;
/* USER CODE BEGIN PV */
#define BSD_THREAD_STACK_SIZE  4096
/* USER CODE END PV */

static VOID nx_app_thread_entry (ULONG thread_input);
/**
  * @brief  Application NetXDuo Initialization.
  * @param memory_ptr: memory pointer
  * @retval int
  */
UINT MX_NetXDuo_Init(VOID *memory_ptr)
{
  UINT ret = NX_SUCCESS;
  TX_BYTE_POOL *byte_pool = (TX_BYTE_POOL*)memory_ptr;
  CHAR *pointer;

  /* Initialize the NetXDuo system. */
  nx_system_initialize();

    /* Allocate the memory for packet_pool.  */
  if (tx_byte_allocate(byte_pool, (VOID **) &pointer, NX_APP_PACKET_POOL_SIZE, TX_NO_WAIT) != TX_SUCCESS)
  {
    return TX_POOL_ERROR;
  }

  /* Create the Packet pool to be used for packet allocation,
   * If extra NX_PACKET are to be used the NX_APP_PACKET_POOL_SIZE should be increased
   */
  ret = nx_packet_pool_create(&NxAppPool, "NetXDuo App Pool", DEFAULT_PAYLOAD_SIZE, pointer, NX_APP_PACKET_POOL_SIZE);

  if (ret != NX_SUCCESS)
  {
    return NX_POOL_ERROR;
  }

    /* Allocate the memory for Ip_Instance */
  if (tx_byte_allocate(byte_pool, (VOID **) &pointer, Nx_IP_INSTANCE_THREAD_SIZE, TX_NO_WAIT) != TX_SUCCESS)
  {
    return TX_POOL_ERROR;
  }

   /* Create the main NX_IP instance */
  ret = nx_ip_create(&NetXDuoEthIpInstance, "NetX Ip instance", NX_APP_DEFAULT_IP_ADDRESS, NX_APP_DEFAULT_NET_MASK, &NxAppPool, nx_stm32_eth_driver,
                     pointer, Nx_IP_INSTANCE_THREAD_SIZE, NX_APP_INSTANCE_PRIORITY);

  if (ret != NX_SUCCESS)
  {
    return NX_NOT_SUCCESSFUL;
  }

    /* Allocate the memory for ARP */
  if (tx_byte_allocate(byte_pool, (VOID **) &pointer, DEFAULT_ARP_CACHE_SIZE, TX_NO_WAIT) != TX_SUCCESS)
  {
    return TX_POOL_ERROR;
  }

  /* Enable the ARP protocol and provide the ARP cache size for the IP instance */

  ret = nx_arp_enable(&NetXDuoEthIpInstance, (VOID *)pointer, DEFAULT_ARP_CACHE_SIZE);

  if (ret != NX_SUCCESS)
  {
    return NX_NOT_SUCCESSFUL;
  }

  /* Enable the ICMP */

  ret = nx_icmp_enable(&NetXDuoEthIpInstance);

  if (ret != NX_SUCCESS)
  {
    return NX_NOT_SUCCESSFUL;
  }

  /* Enable TCP Protocol */

  ret = nx_tcp_enable(&NetXDuoEthIpInstance);

  if (ret != NX_SUCCESS)
  {
    return NX_NOT_SUCCESSFUL;
  }

  /* Enable the UDP protocol required for  DHCP communication */

  ret = nx_udp_enable(&NetXDuoEthIpInstance);

  if (ret != NX_SUCCESS)
  {
    return NX_NOT_SUCCESSFUL;
  }

   /* Allocate the memory for main thread   */
  if (tx_byte_allocate(byte_pool, (VOID **) &pointer, NX_APP_THREAD_STACK_SIZE, TX_NO_WAIT) != TX_SUCCESS)
  {
    return TX_POOL_ERROR;
  }

  /* Create the main thread */
  ret = tx_thread_create(&NxAppThread, "NetXDuo App thread", nx_app_thread_entry , 0, pointer, NX_APP_THREAD_STACK_SIZE,
                         NX_APP_THREAD_PRIORITY, NX_APP_THREAD_PRIORITY, TX_NO_TIME_SLICE, TX_AUTO_START);

  if (ret != TX_SUCCESS)
  {
    return TX_THREAD_ERROR;
  }

  /* USER CODE BEGIN MX_NetXDuo_Init */
	CHAR *bsd_stack_ptr;
	if (tx_byte_allocate(byte_pool, (VOID**) &bsd_stack_ptr, BSD_THREAD_STACK_SIZE,
			TX_NO_WAIT) != TX_SUCCESS)
	{
		return TX_POOL_ERROR;
	}
	ret = (UINT) bsd_initialize(&NetXDuoEthIpInstance, &NxAppPool, bsd_stack_ptr,
			BSD_THREAD_STACK_SIZE, 2);
	hislip_CreateTask();
  /* USER CODE END MX_NetXDuo_Init */

  return ret;
}

/**
* @brief  Main thread entry.
* @param thread_input: ULONG user argument used by the thread entry
* @retval none
*/
static VOID nx_app_thread_entry (ULONG thread_input)
{
}
