BehrensG/ETH1CVOLT/SOFTWARE/IDE/ETH1CVOLT/STM32CubeIDE/Application/User/BSP/dg412.h

/*
 * dg412.h
 *
 *  Created on: Nov 10, 2026
 *      Author: grzegorz
 */

#ifndef APPLICATION_USER_BSP_DG412_H_
#define APPLICATION_USER_BSP_DG412_H_

#include "main.h"

void dg412_init();
void dg412_meas();
void dg412_vref();
void dg412_gnd();

#endif /* APPLICATION_USER_BSP_DG412_H_ */
