BehrensG/ETH1CVOLT/SOFTWARE/IDE/ETH1CVOLT/STM32CubeIDE/Application/User/BSP/max5719.h

/*
 * max5719.h
 *
 *  Created on: Nov 10, 2026
 *      Author: grzegorz
 */

#ifndef APPLICATION_USER_BSP_MAX5719_H_
#define APPLICATION_USER_BSP_MAX5719_H_



#endif /* APPLICATION_USER_BSP_MAX5719_H_ */
