BehrensG/ETH1CVOLT/SOFTWARE/IDE/ETH1CVOLT/STM32CubeIDE/Application/User/SCPI/device_info.h

/*
 * DEVICE_CFG.h
 *
 *  Created on: Jun 18, 2024
 *      Author: grzegorz
 */

#ifndef BSP_INC_DEVICE_INFO_H_
#define BSP_INC_DEVICE_INFO_H_

#define MANUFACTURER					"GB"
#define MODEL							"ETH1CVOLT"
#define SOFTWARE_VERSION				"01.001"
#define MANUFACTURER_DESCRIPTION		"Voltage source"
#define PASSWORD 						"ETH1CVOLT"

#endif /* BSP_INC_DEVICE_INFO_H_ */
