BehrensG/ETH1CVOLT/(commit log)

2026-02-27 Hardware development
    [BlockDiagram.kicad_sch, Connectors_Input.kicad_sch, DC_DC_Isolated.kicad_sch, ETH1CVOLT_A.kicad_pcb, Ethernet.kicad_sch, High_Voltage.kicad_sch, Isolation_IO.kicad_sch, Low_Voltage.kicad_sch]
2026-09-11 Design is being simplified
    [ADC.kicad_sch, BlockDiagram.kicad_sch, Block_Diagram.kicad_sch, DAC.kicad_sch, DC_DC_Isolated.kicad_sch, ETH1CVOLT.kicad_pcb, ETH1CVOLT.kicad_sch, ETH1CVOLT_A.kicad_pcb]
2026-09-19 Layout and schematic
    [ADC.kicad_sch, Block_Diagram.kicad_sch, DAC.kicad_sch, ETH1CVOLT.csv, ETH1CVOLT.kicad_pcb, ETH1CVOLT.kicad_sch, Ethernet.kicad_sch, Isolated_Power.kicad_sch]
2026-09-20 Layout done
    [ETH1CVOLT.csv, ETH1CVOLT.kicad_pcb, Voltage_Reference.kicad_sch]
2026-09-29 HW design done
    [ADC.kicad_sch, ETH1CVOLT.kicad_pcb, Isolated_Power.kicad_sch, Isolation_Digital.kicad_sch, MCU.kicad_sch, Power.kicad_sch]
2026-09-30 Production data, cleanup.
    [ADC.kicad_sch, BlockDiagram.kicad_sch, Block_Diagram.kicad_sch, Connectors_Input.kicad_sch, Connectors_Output.kicad_sch, Current_Measurement.kicad_sch, DAC.kicad_sch, DAC_Supply.kicad_sch]
2026-10-23 Example in https://github.com/stm32-hotspot/NUCLEO_H743_NetXDuo_UDP_IPv4_IPv6 is not valid.
