BehrensG/ETH1CVOLT/(notices)

Notices in the files:
SOFTWARE/MX/ETH1CVOLT_MX/Core/Src/main.c:
Copyright (c) 2026 STMicroelectronics.
All rights reserved.
This software is licensed under terms that can be found in the LICENSE file
SOFTWARE/IDE/ETH1CVOLT/NetXDuo/App/app_netxduo.h:
Copyright (c) 2020-2021 STMicroelectronics.
